costarc/MSX_FPGA_Hat/Hardware Interface/MSX_FPGA_Hat.png

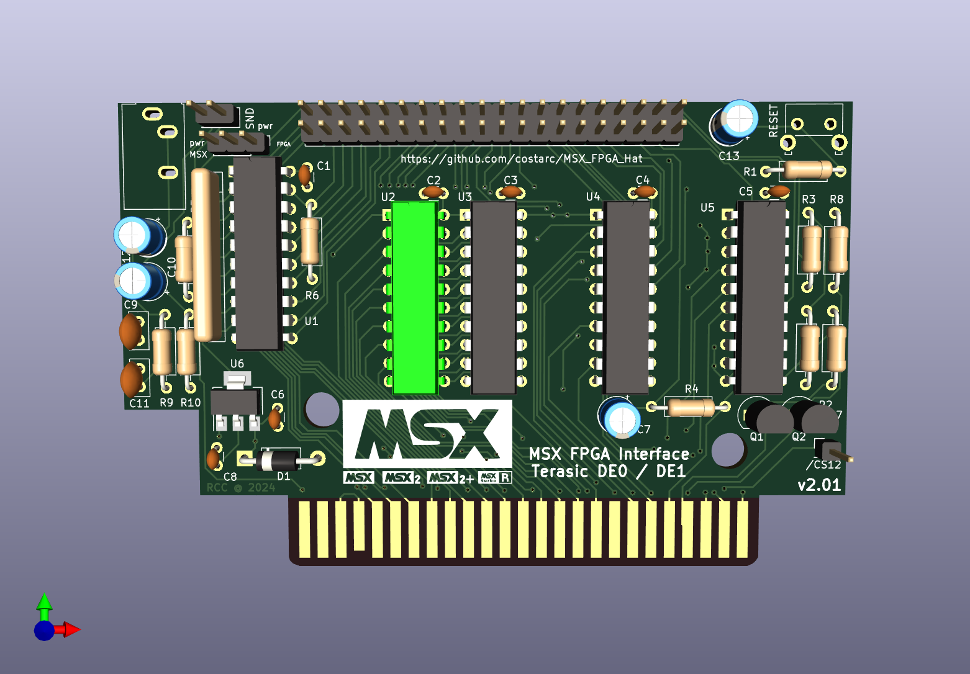
Hardware Interface/MSX_FPGA_Hat.png
