costarc/MSX_FPGA_Hat/Hardware Interface/MSX_FPGA_Hat_b.png

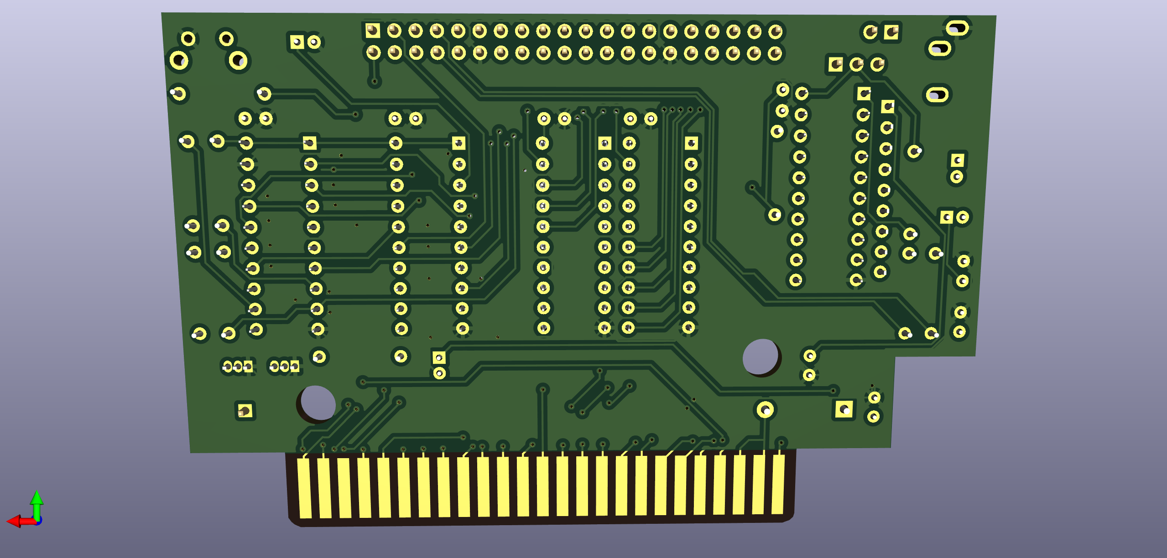
Hardware Interface/MSX_FPGA_Hat_b.png
