costarc/MSX_FPGA_Hat/Reference Designs/Altera DE0 Project/MegaROM_ASCII16/README.md

Design: MegaROM_Konami8

Function: Implements the ASCII16 mapper - 16KB Banks

Features: 
 1. ROMs read from the external Flash ram board
 2. Switch roms using the SW switches

Quick Start Guide
-----------------

1. Connect everything and turn on the DE board
2. Program the DE board with the .sof file
3. Move SW9 to UP position to enable the cartridge core
4. Select the game using SW0, SW1 OR SW3 
   SW0 allows to choose between 2 ROMs moving UP or Down
   SW1 and SW3 select 1 game each when in UP position
