costarc/MSX_FPGA_Hat/Hardware Interface/DE0_Addon_Board/DE0_Addon_Board.png

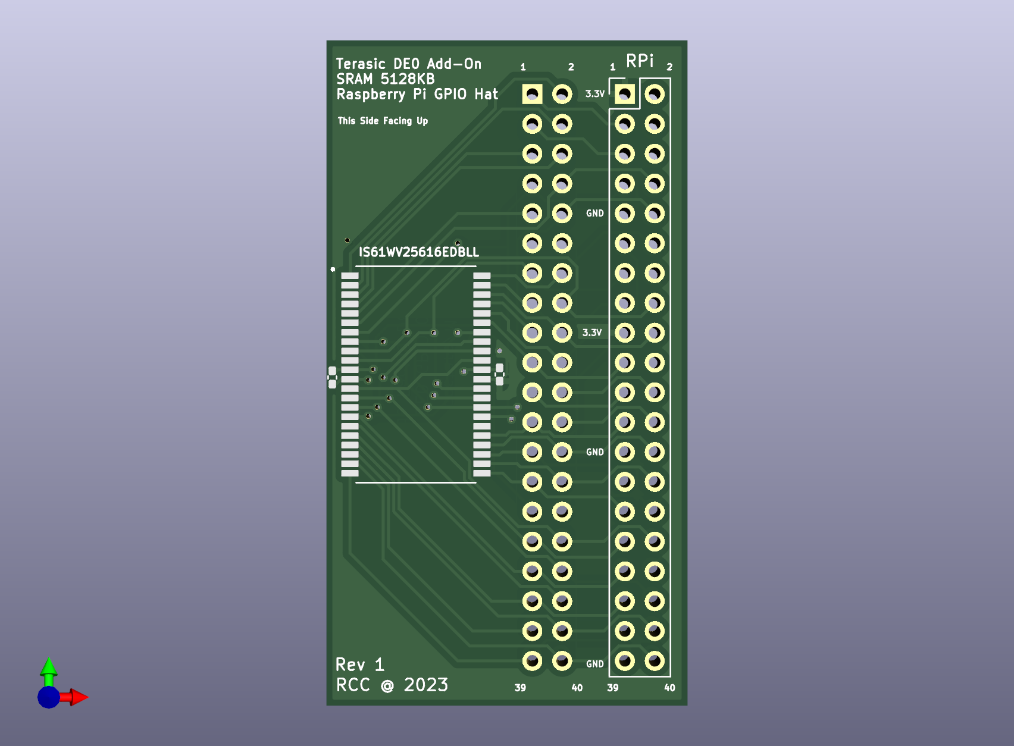
Hardware Interface/DE0_Addon_Board/DE0_Addon_Board.png
