costarc/MSX_FPGA_Hat/Hardware Interface/DE0_Addon_Board/Pin Mapping.png

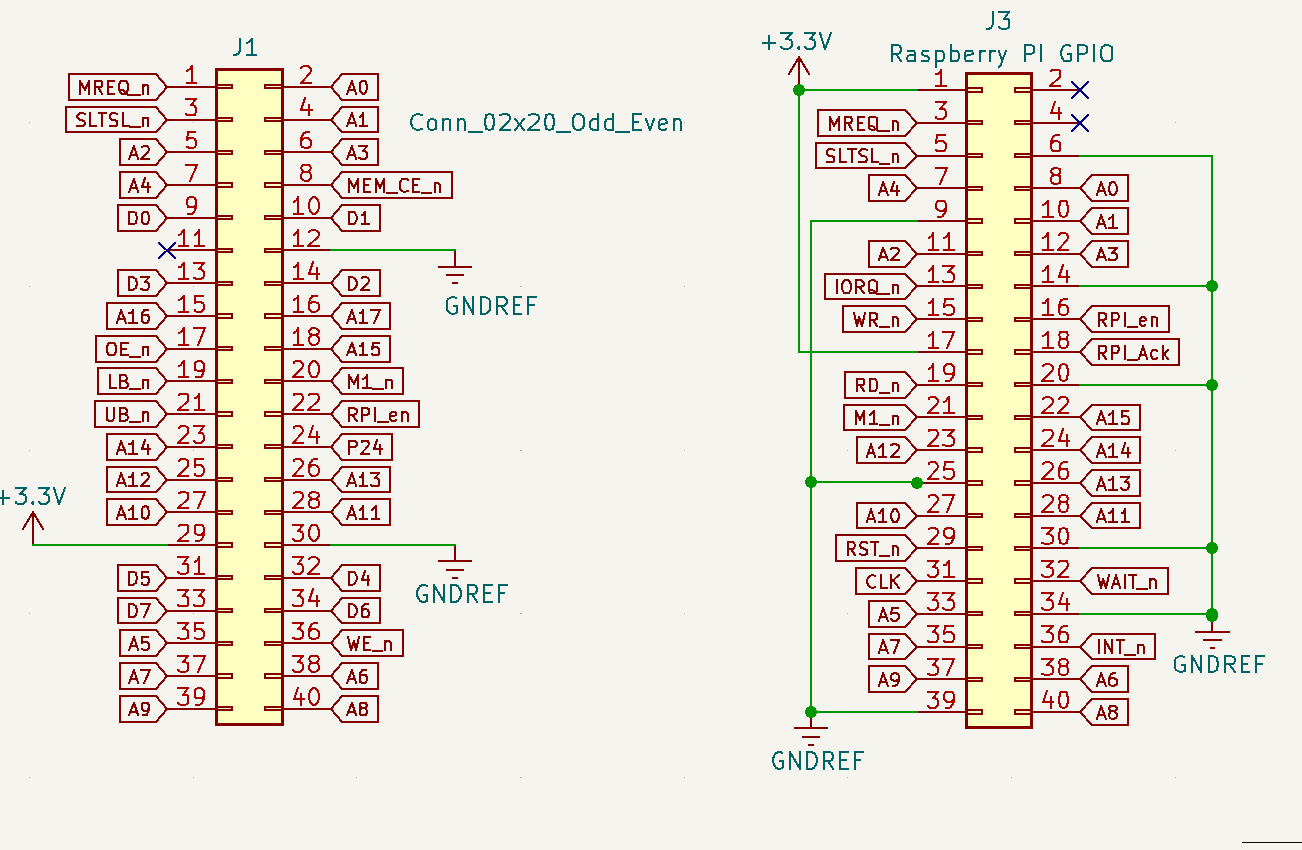
Hardware Interface/DE0_Addon_Board/Pin Mapping.png
