costarc/MSX_FPGA_Hat/Hardware Interface/v1.6/MSX_FPGA_Hat.png

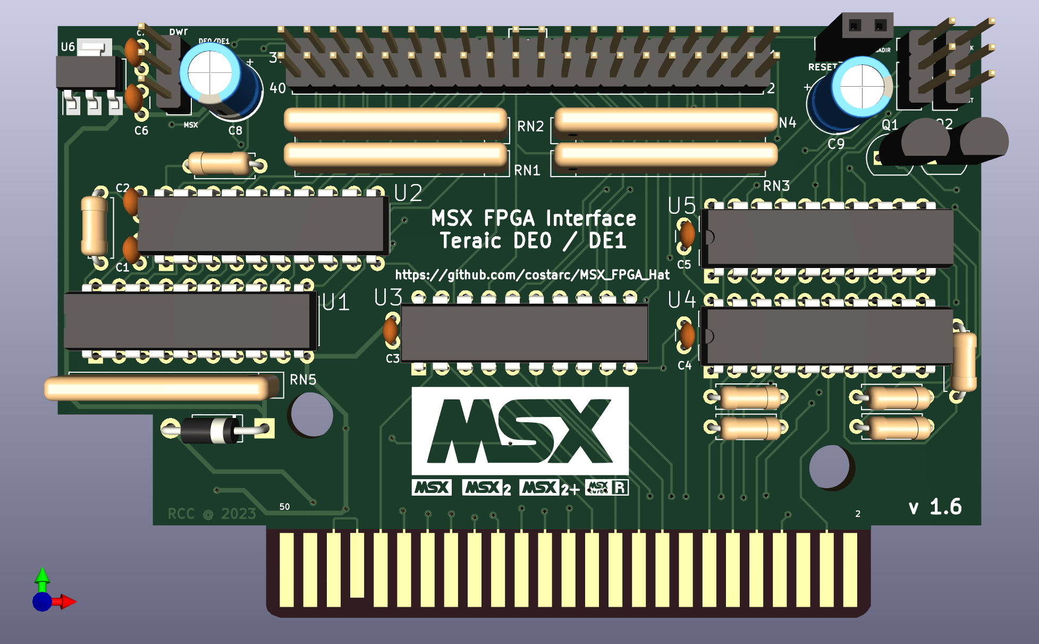
Hardware Interface/v1.6/MSX_FPGA_Hat.png
