costarc/MSX_FPGA_Hat/Hardware Interface/v1.6/MSX_FPGA_Hat.pdf

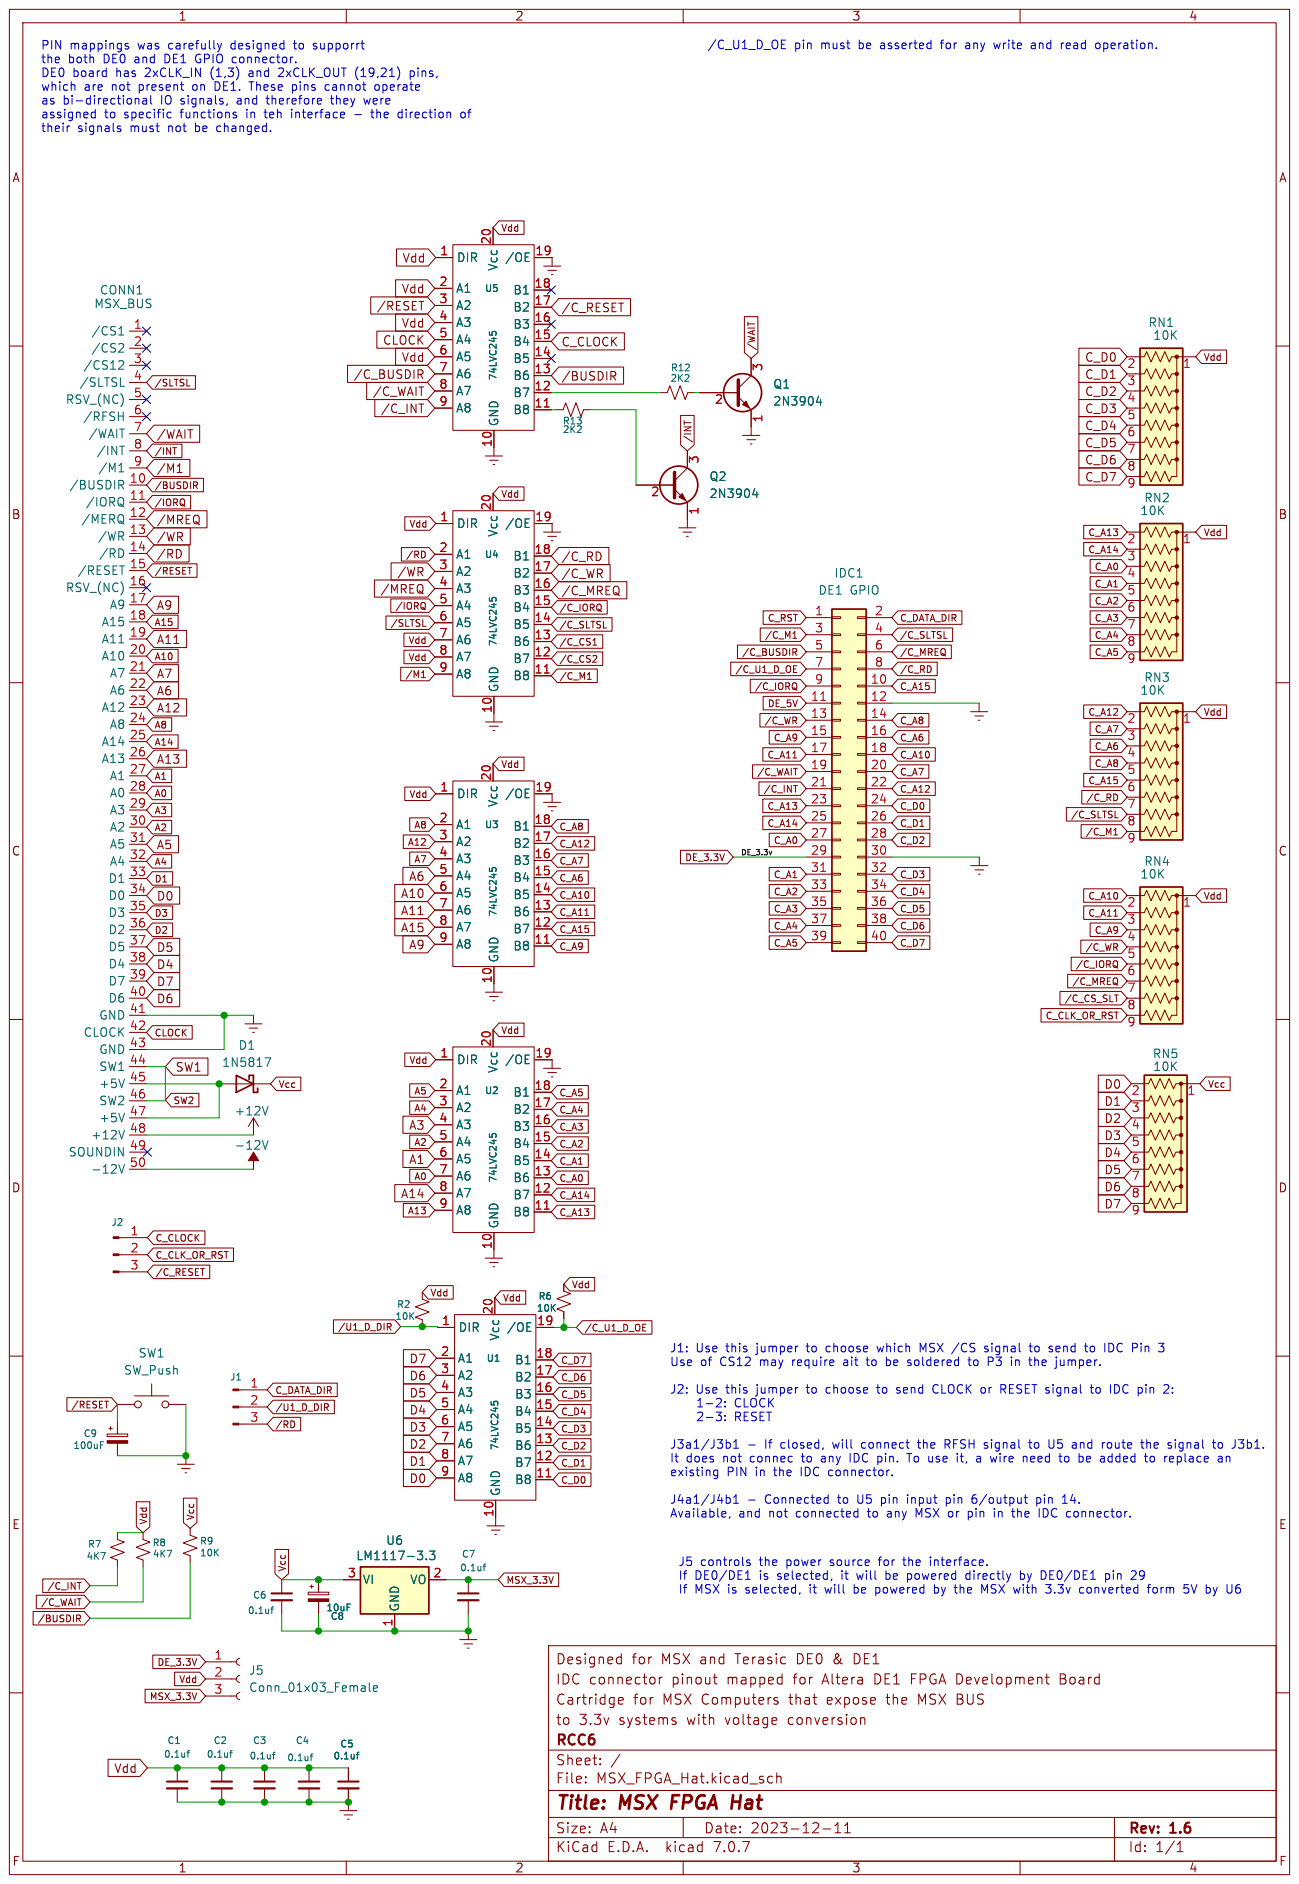
[picture p6: page 1]

/C_U1_D_OE pin must be asserted for any write and read operation.

their signals must not be changed.

It does not connec to any IDC pin. To use it, a wire need to be added to replace an
