costarc/MSX_FPGA_Hat/Hardware Interface/DE0_Addon_Board/DE0_Addon_Board.pdf

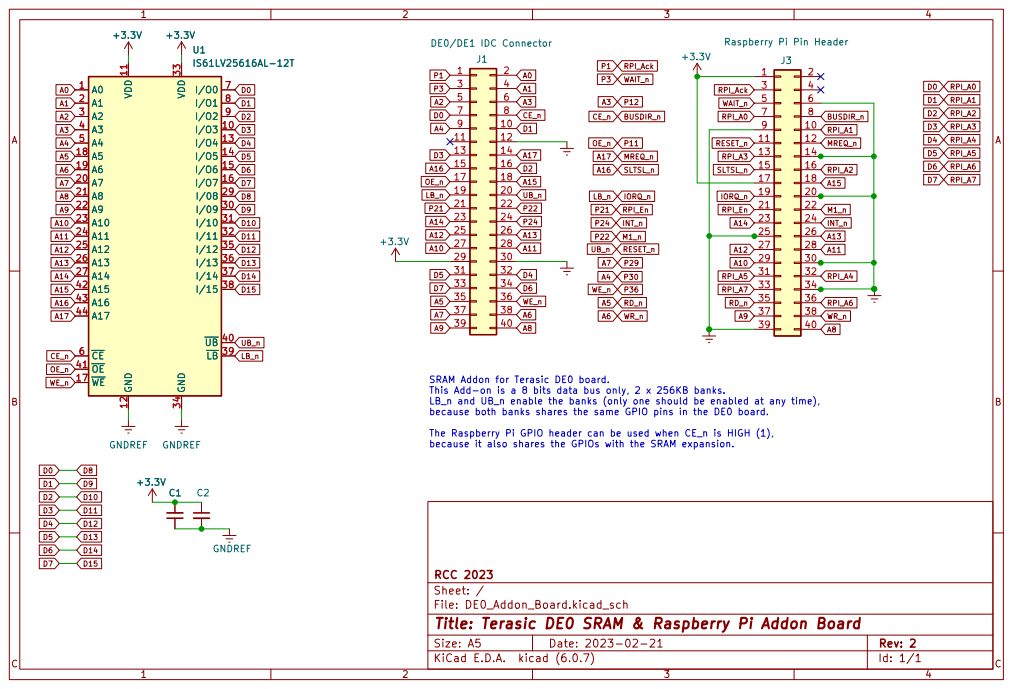
[picture p7: page 1]

+3.3V

J3 Raspberry Pi Pin Header GNDREF

LB_n and UB_n enable the banks (only one should be enabled at any time),
because both banks shares the same GPIO pins in the DE0 board.

The Raspberry Pi GPIO header can be used when CE_n is HIGH (1),

Id: 1/1 Title: Terasic DE0 SRAM & Raspberry Pi Addon Board
