costarc/MSX_FPGA_Hat/Reference Designs/Altera DE0 Project/SDMapper/SDPINOUT.pdf

## DAT2 N/C

## DAT3 CS#

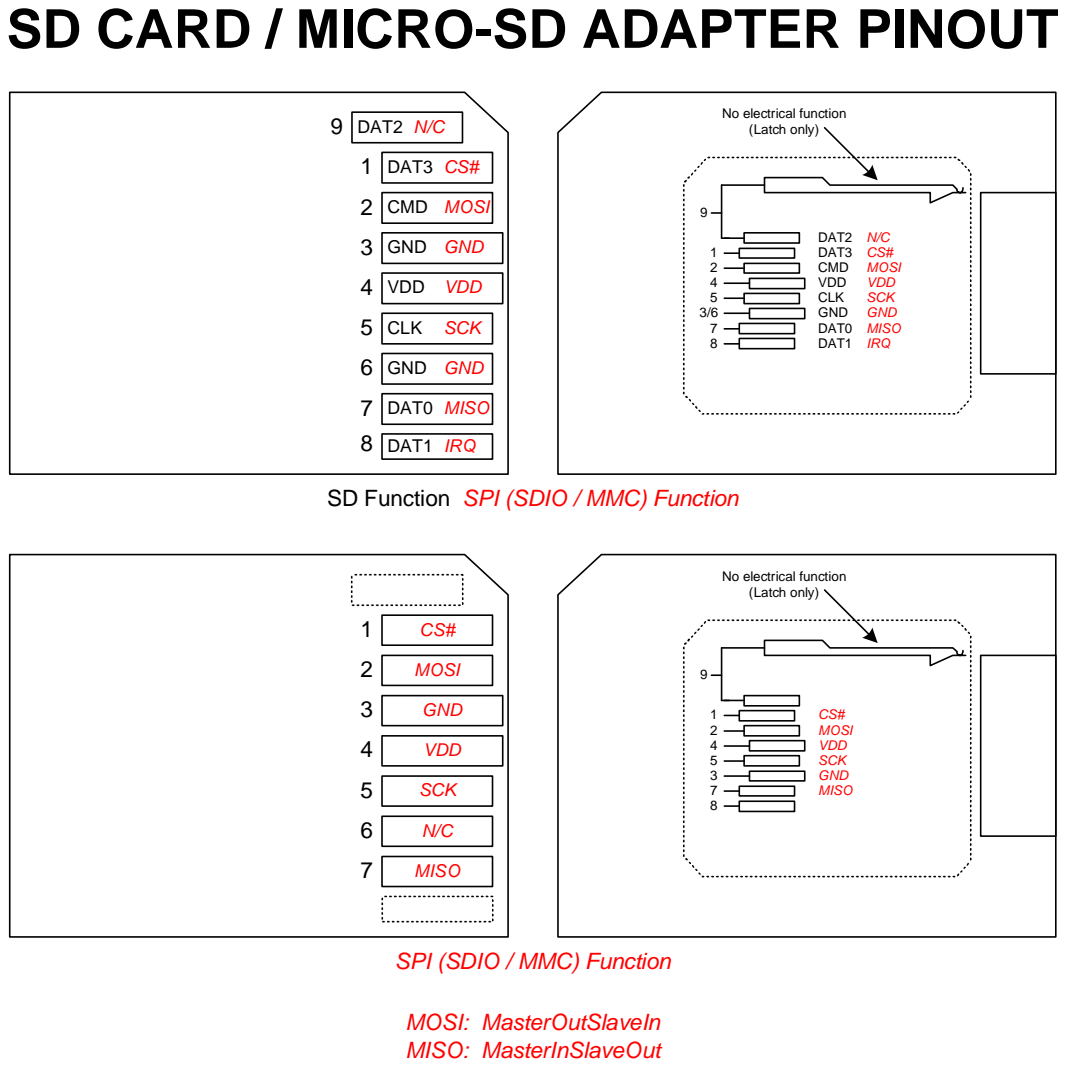
[picture p8: page 1]
CMD MOSI; GND GND; VDD VDD; CLK SCK; DAT0 MISO; DAT1 IRQ; DAT2 N/C DAT3 CS# CMD MOSI; VDD; CLK; SCK; GND; DAT0 MISO DAT1 IRQ; MOSI; MISO; CS# MOSI VDD SCK GND MISO; MOSI: MasterOutSlaveIn MISO: MasterInSlaveOut

SD CARD / MICRO-SD ADAPTER PINOUT

No electrical function
(Latch only)

SD Function SPI (SDIO / MMC) Function

SPI (SDIO / MMC) Function
