costarc/MSX_FPGA_Hat/Hardware Interface/Previous Versions/v1.0/MSX_IDC_Interface.pdf

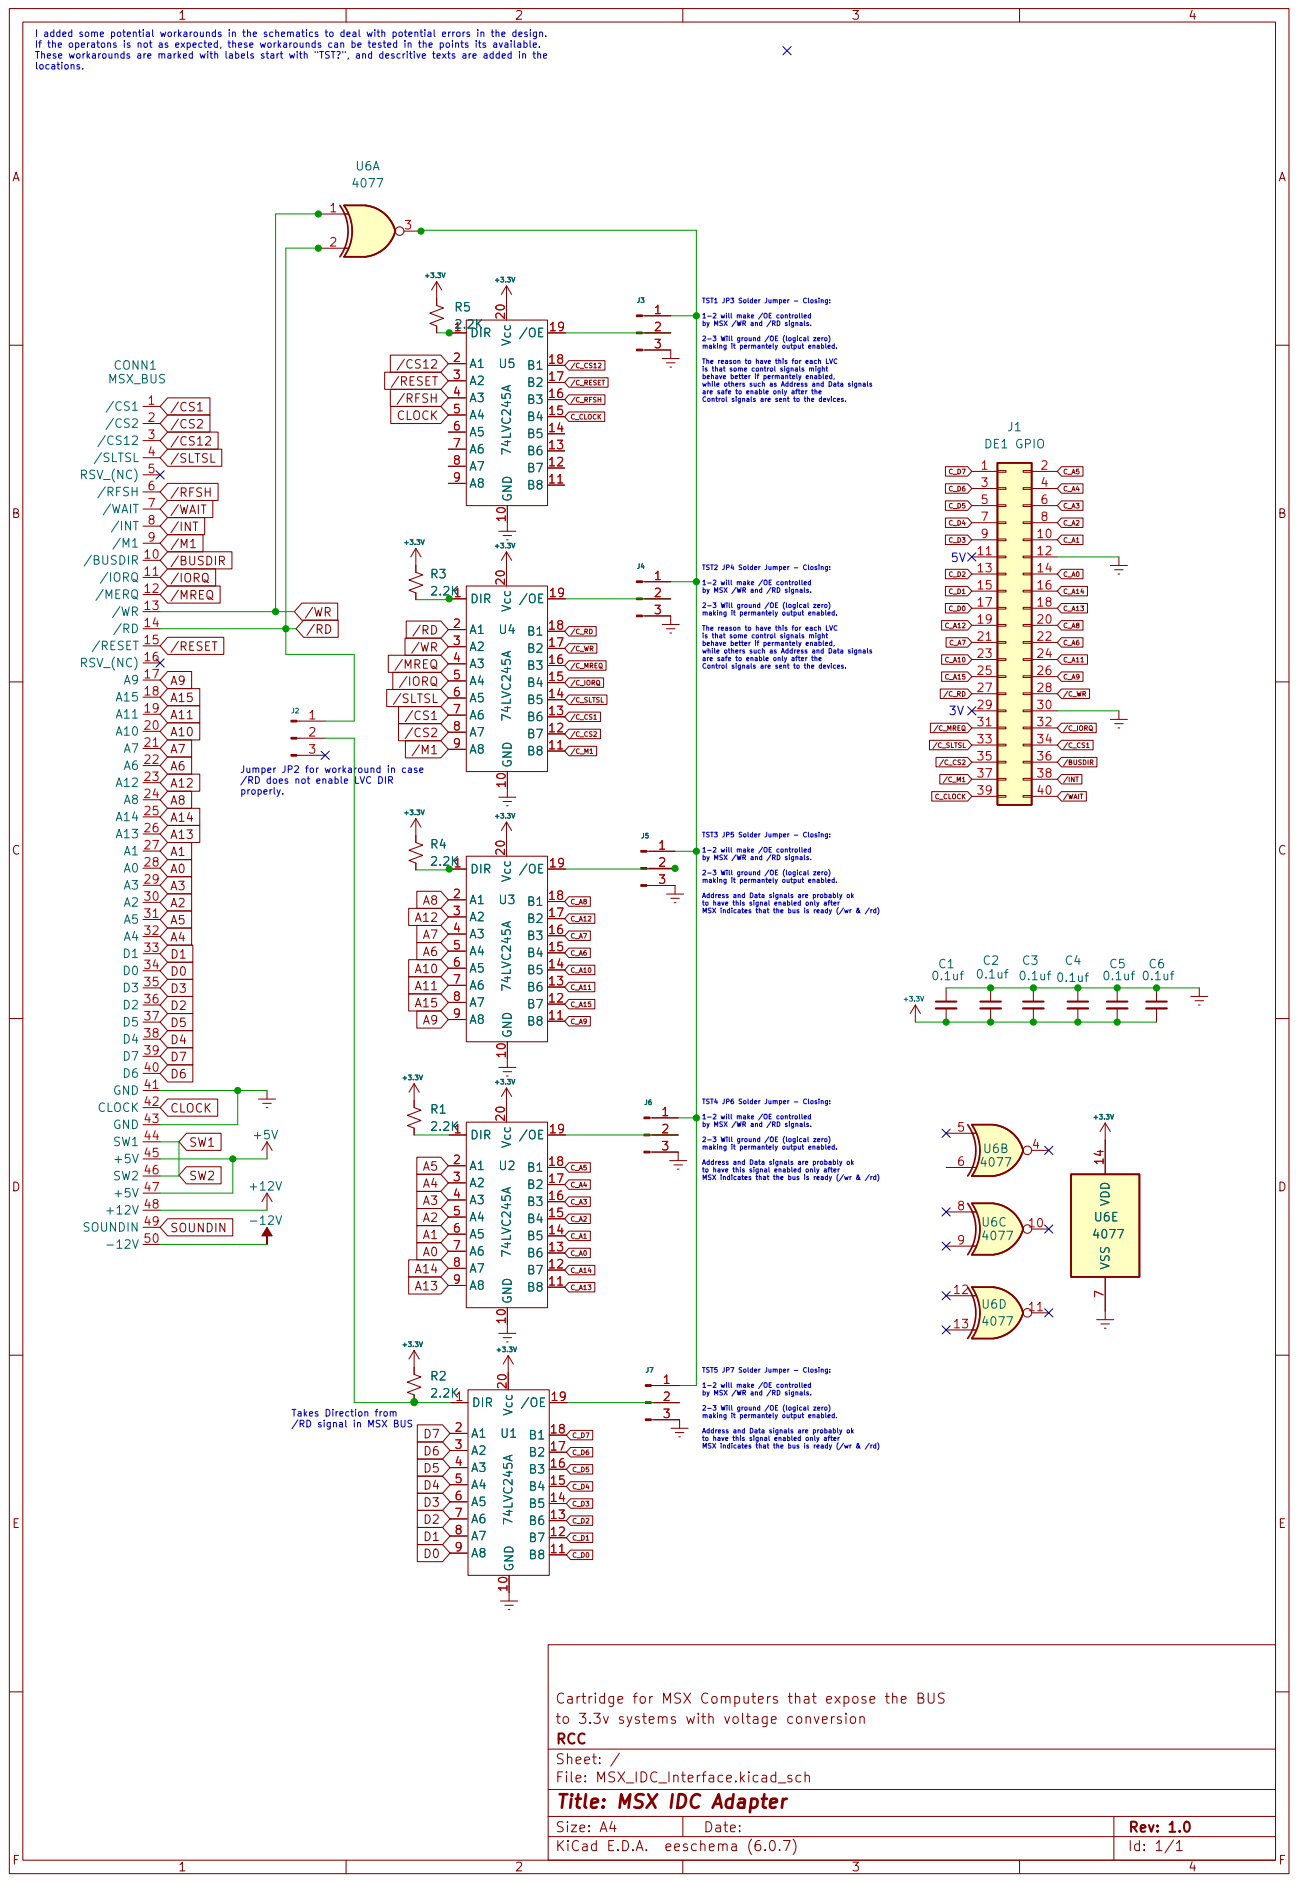
[picture p10: page 1]

I added some potential workarounds in the schematics to deal with potential errors in the design.
If the operatons is not as expected, these workarounds can be tested in the points its available. These workarounds are marked with labels start with "TST?", and descritive texts are added in the

TST1 JP3 Solder Jumper - Closing: 1-2 will make /OE controlled

by MSX /WR and /RD signals. 2-3 Will ground /OE (logical zero) making it permantely output enabled. The reason to have this for each LVC

is that some control signals might behave better if permantely enabled, while others such as Address and Data signals are safe to enable only after the Control signals are sent to the devices.

TST2 JP4 Solder Jumper - Closing: 1-2 will make /OE controlled

Jumper JP2 for workaround in case
/RD does not enable LVC DIR
properly.

by MSX /WR and /RD signals. 2-3 Will ground /OE (logical zero) making it permantely output enabled. Address and Data signals are probably ok

to have this signal enabled only after MSX indicates that the bus is ready (/wr & /rd)

to have this signal enabled only after MSX indicates that the bus is ready (/wr & /rd) Takes Direction from
/RD signal in MSX BUS

Cartridge for MSX Computers that expose the BUS
to 3.3v systems with voltage conversion
File: MSX_IDC_Interface.kicad_sch Sheet: / RCC

Id: 1/1 Title: MSX IDC Adapter
