costarc/MSX_FPGA_Hat/Hardware Interface/v1.2/DE0_Addon_Board/DE0_Addon_Board.pdf

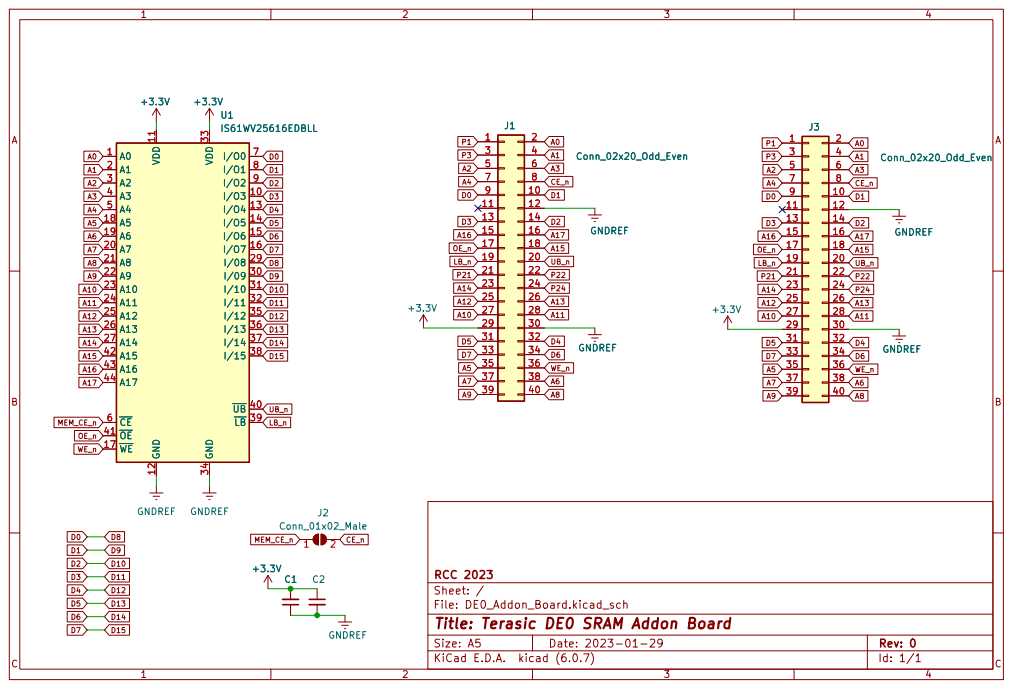
[picture p12: page 1]

Id: 1/1 Title: Terasic DE0 SRAM Addon Board
