costarc/MSX_FPGA_Hat/Hardware Interface/Previous Versions/v1.0/MSX_IDC_ADAPTER.pdf

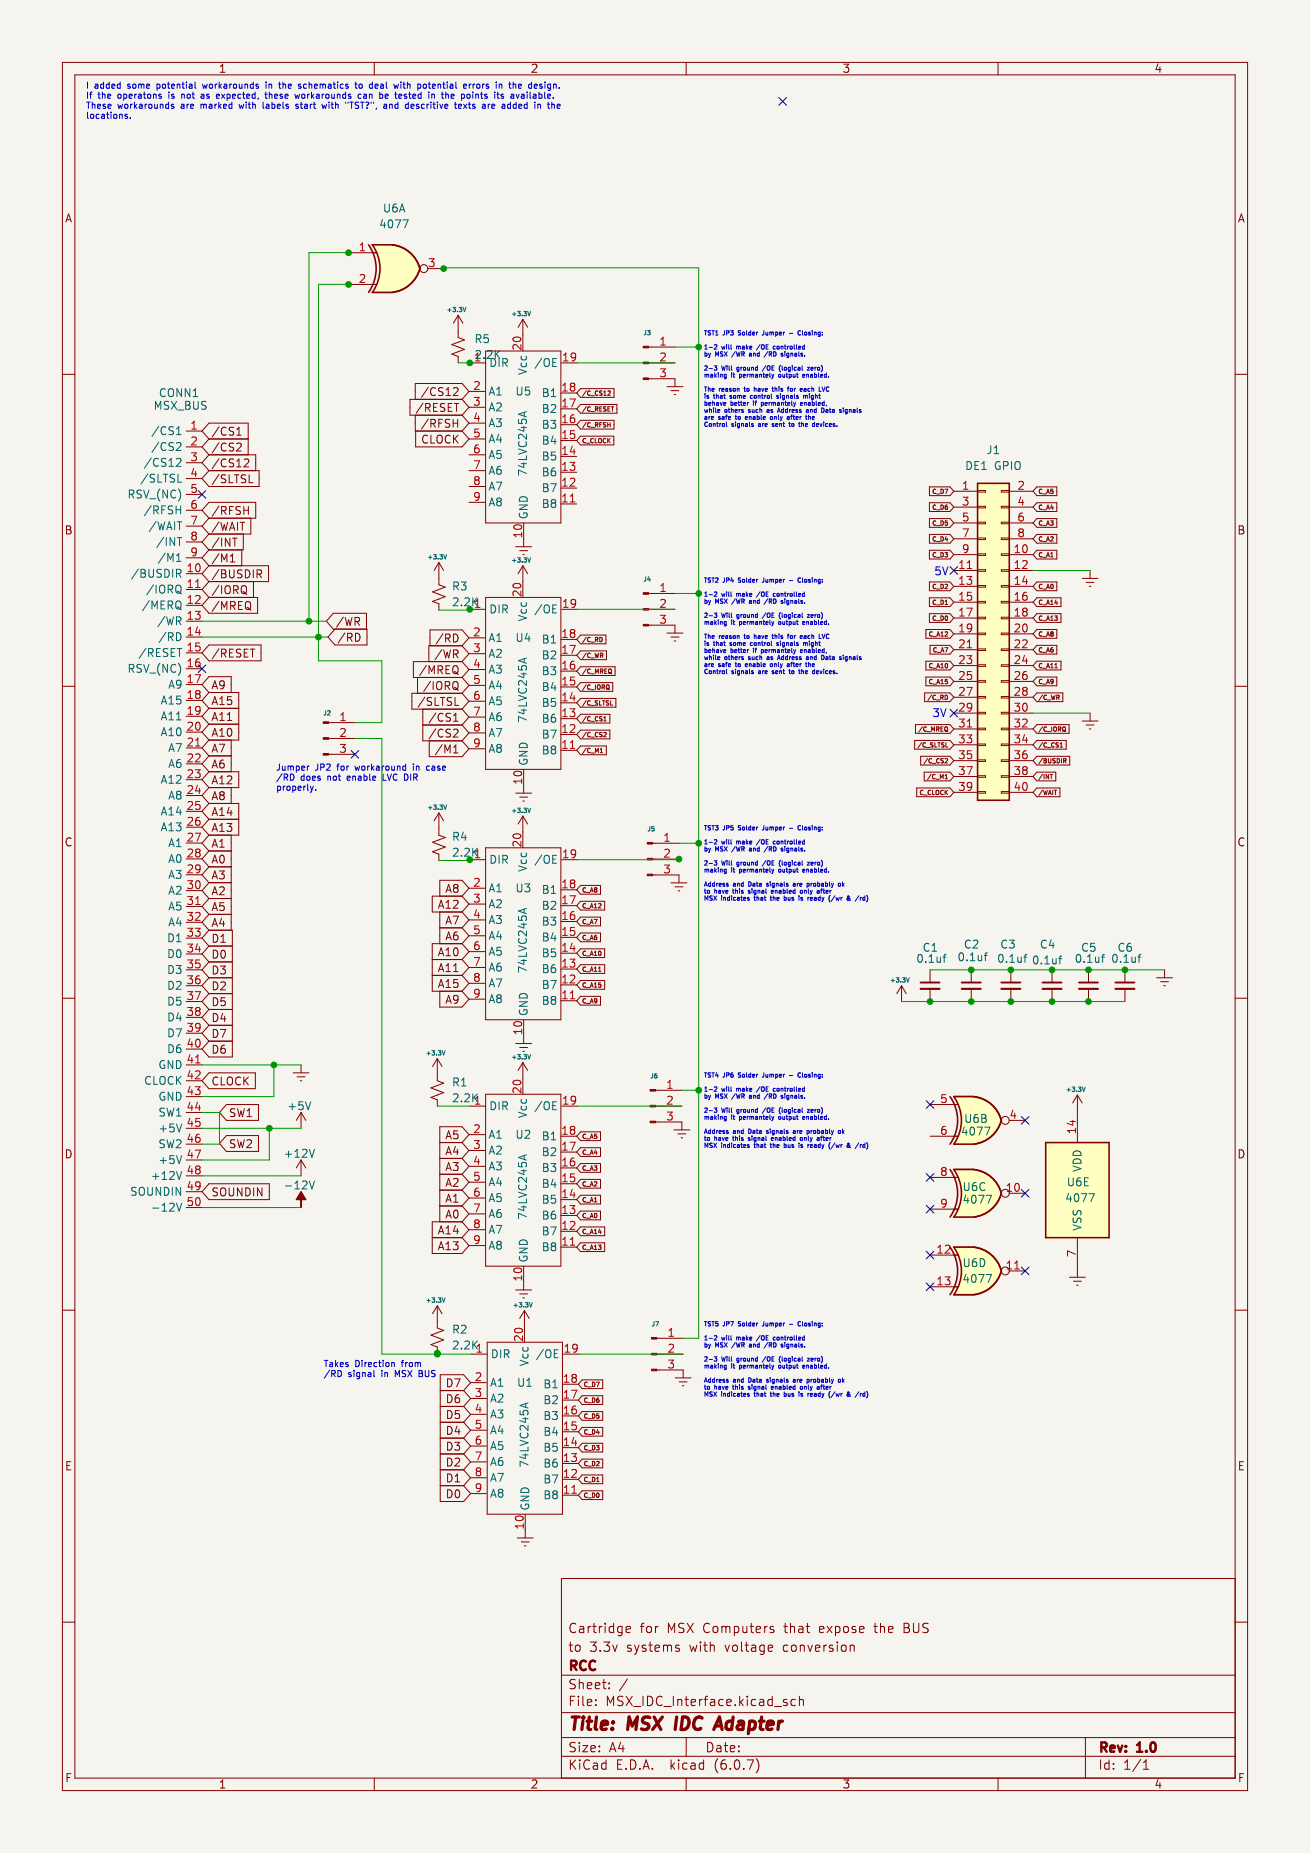
[picture p13: page 1]
