costarc/MSX_FPGA_Hat/Hardware Interface/Previous Versions/v1.1/MSX_FPGA_Hat.kicad_pcb

## KiCad design Hardware Interface/Previous Versions/v1.1/MSX_FPGA_Hat.kicad_pcb (2023-01-31, an earlier design)

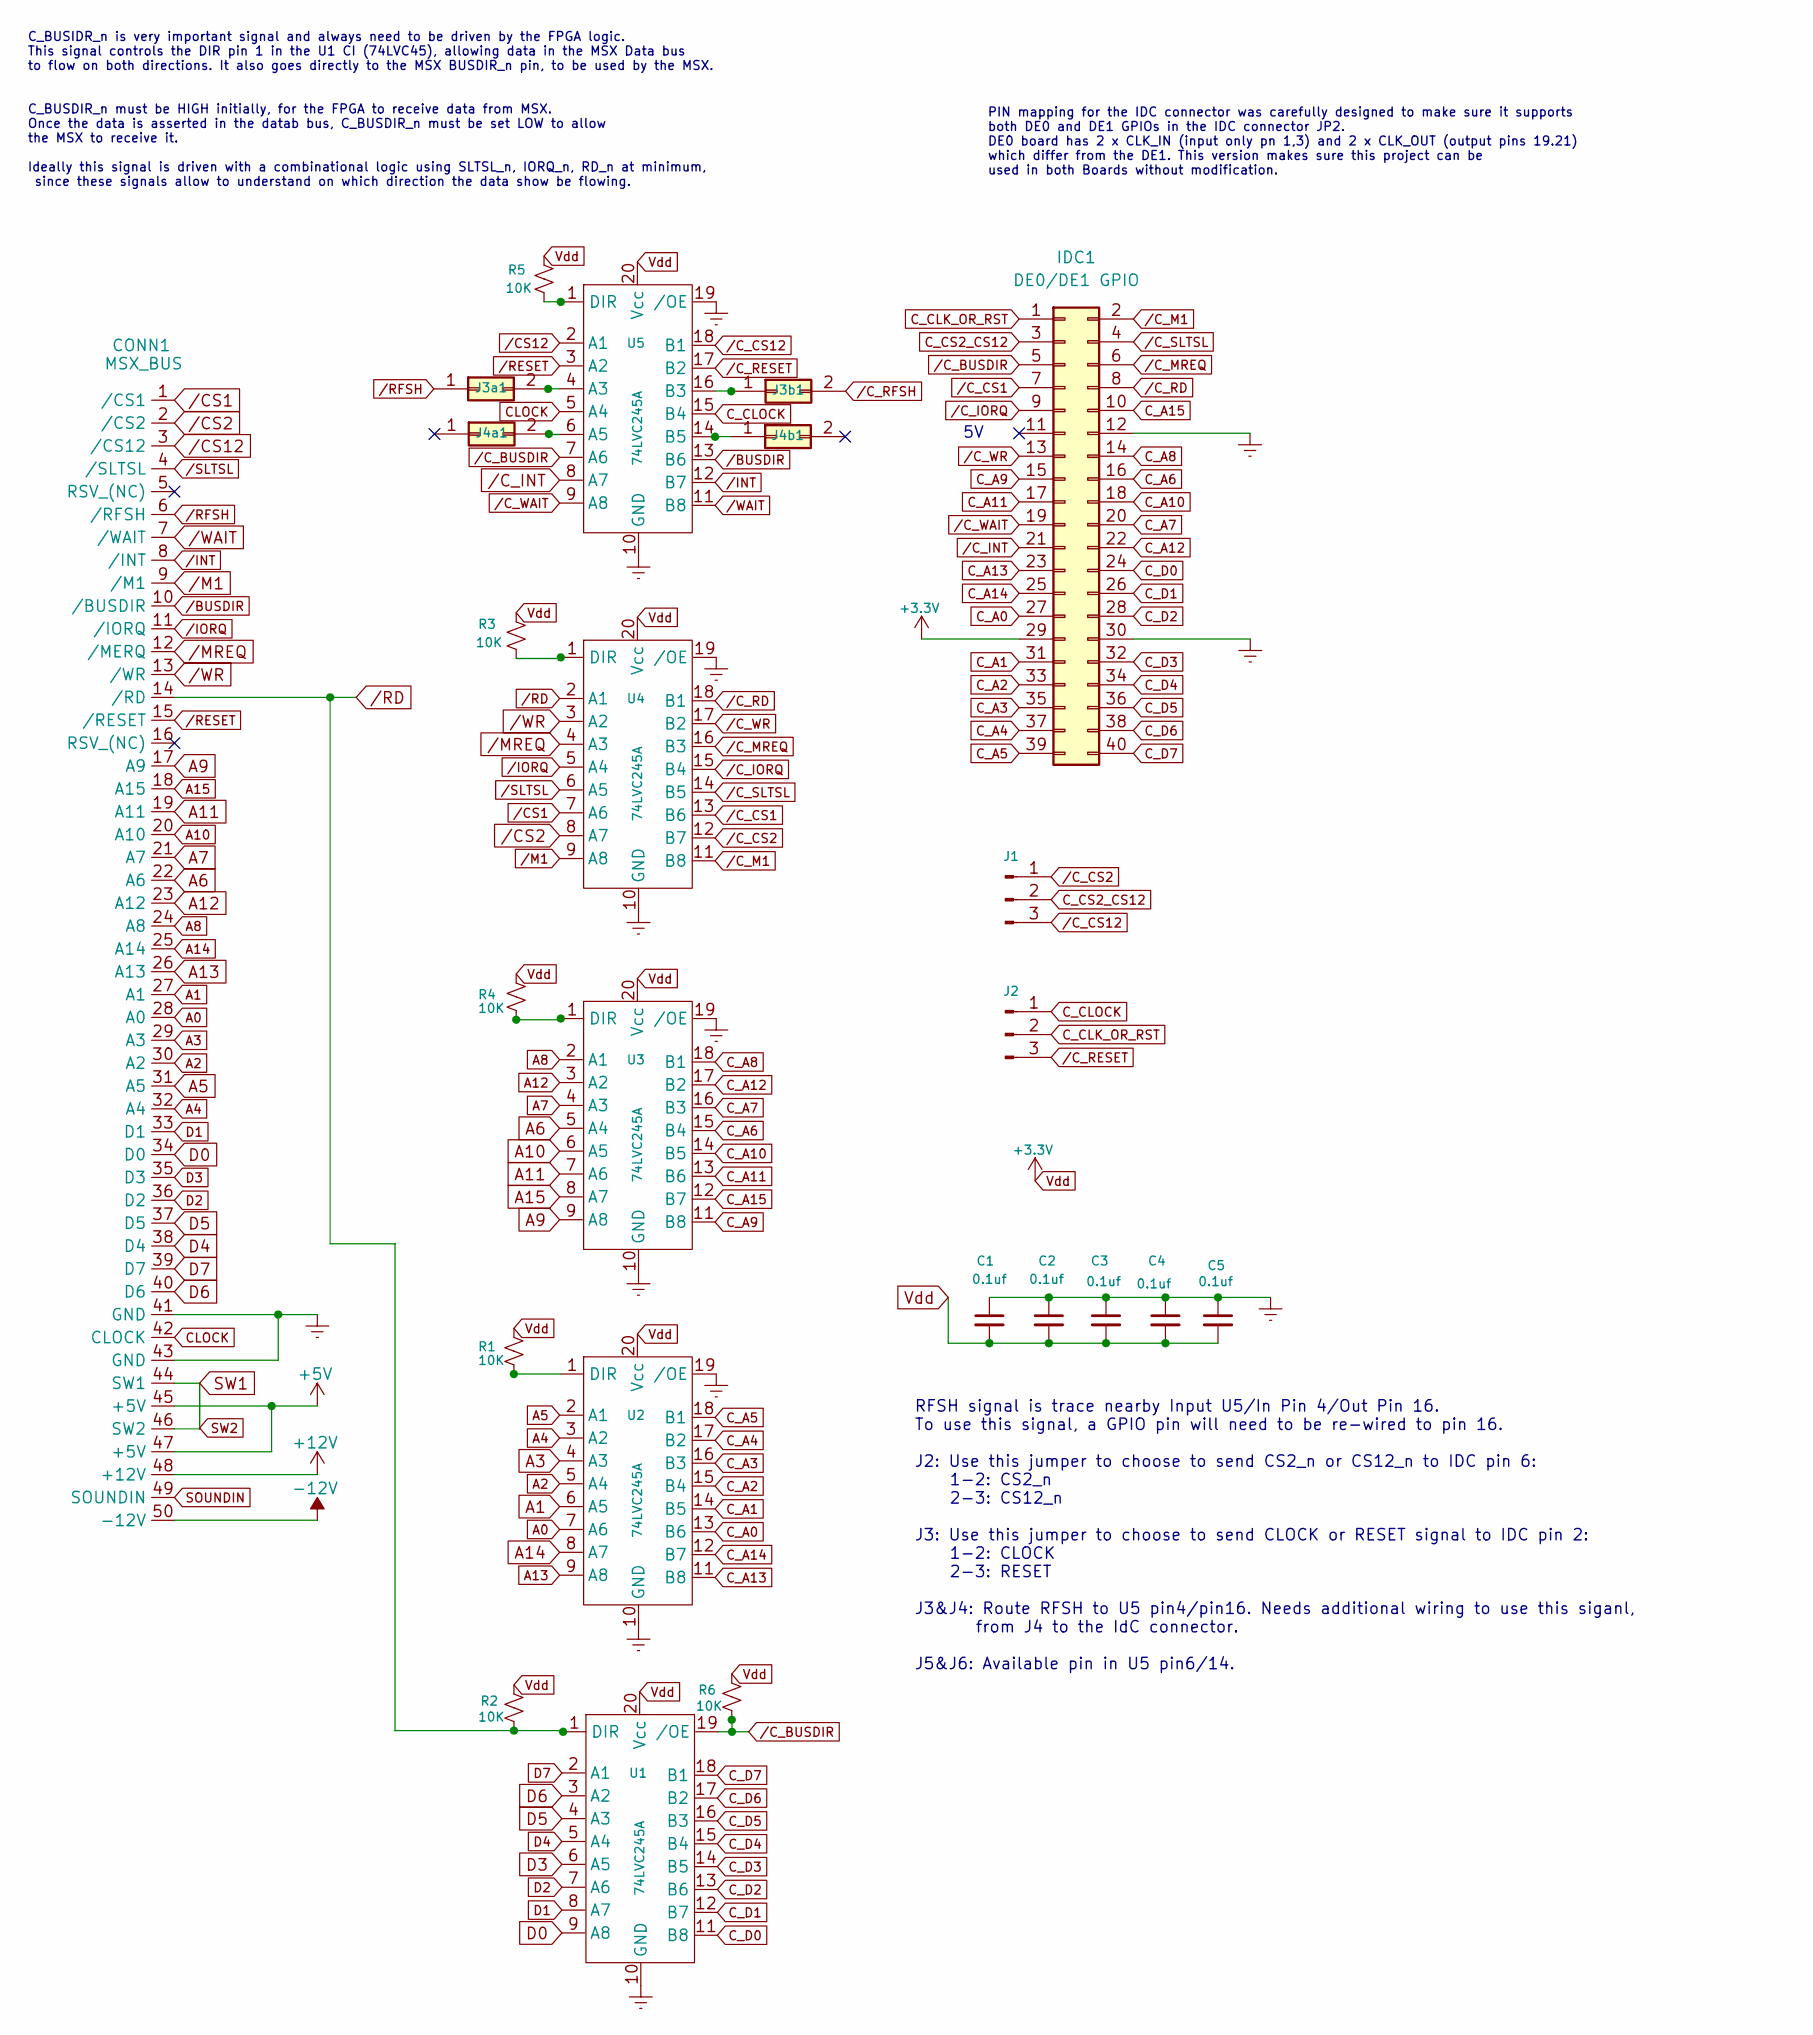
[picture p16: schematic MSX_FPGA_Hat.kicad_sch, MSX FPGA Hat]

Parts:
C1, C2, C3, C4, C5: 0.1uf; C_Disc_D3.0mm_W1.6mm_P2.50mm
CONN1: MSX_BUS; MSX_CART
IDC1: DE0/DE1 GPIO; PinHeader_2x20_P2.54mm_Vertical
J1: J1; PinHeader_1x03_P2.54mm_Vertical
J2: J2; PinHeader_1x03_P2.54mm_Vertical
J3a1: J3a; PinHeader_1x02_P2.54mm_Vertical
J3b1: J3b; PinHeader_1x02_P2.54mm_Vertical
J4a1: J4a; PinHeader_1x02_P2.54mm_Vertical
J4b1: J4b; PinHeader_1x02_P2.54mm_Vertical
R1, R2, R3, R4, R5, R6: 10K; R_Axial_DIN0207_L6.3mm_D2.5mm_P7.62mm_Horizontal
U1, U2, U3, U4, U5: 74LVC245A; DIP-20_W7.62mm

Connections:
+5V: CONN1.45 (+5V), CONN1.47 (+5V)
+12V: CONN1.48 (+12V)
-12V: CONN1.50 (-12V)
A0: CONN1.28 (A0), U2.7 (A6)
A1: CONN1.27 (A1), U2.6 (A5)
A2: CONN1.30 (A2), U2.5 (A4)
A3: CONN1.29 (A3), U2.4 (A3)
A4: CONN1.32 (A4), U2.3 (A2)
A5: CONN1.31 (A5), U2.2 (A1)
A6: CONN1.22 (A6), U3.5 (A4)
A7: CONN1.21 (A7), U3.4 (A3)
A8: CONN1.24 (A8), U3.2 (A1)
A9: CONN1.17 (A9), U3.9 (A8)
A10: CONN1.20 (A10), U3.6 (A5)
A11: CONN1.19 (A11), U3.7 (A6)
A12: CONN1.23 (A12), U3.3 (A2)
A13: CONN1.26 (A13), U2.9 (A8)
A14: CONN1.25 (A14), U2.8 (A7)
A15: CONN1.18 (A15), U3.8 (A7)
CLOCK: CONN1.42 (CLOCK), U5.5 (A4)
C_A0: IDC1.27, U2.13 (B6)
C_A1: IDC1.31, U2.14 (B5)
C_A2: IDC1.33, U2.15 (B4)
C_A3: IDC1.35, U2.16 (B3)
C_A4: IDC1.37, U2.17 (B2)
C_A5: IDC1.39, U2.18 (B1)
C_A6: IDC1.16, U3.15 (B4)
C_A7: IDC1.20, U3.16 (B3)
C_A8: IDC1.14, U3.18 (B1)
C_A9: IDC1.15, U3.11 (B8)
C_A10: IDC1.18, U3.14 (B5)
C_A11: IDC1.17, U3.13 (B6)
C_A12: IDC1.22, U3.17 (B2)
C_A13: IDC1.23, U2.11 (B8)
C_A14: IDC1.25, U2.12 (B7)
C_A15: IDC1.10, U3.12 (B7)
C_CLK_OR_RST: IDC1.1, J2.2
C_CLOCK: J2.1, U5.15 (B4)
C_CS2_CS12: IDC1.3, J1.2
C_D0: IDC1.24, U1.11 (B8)
C_D1: IDC1.26, U1.12 (B7)
C_D2: IDC1.28, U1.13 (B6)
C_D3: IDC1.32, U1.14 (B5)
C_D4: IDC1.34, U1.15 (B4)
C_D5: IDC1.36, U1.16 (B3)
C_D6: IDC1.38, U1.17 (B2)
C_D7: IDC1.40, U1.18 (B1)
D0: CONN1.34 (D0), U1.9 (A8)
D1: CONN1.33 (D1), U1.8 (A7)
D2: CONN1.36 (D2), U1.7 (A6)
D3: CONN1.35 (D3), U1.6 (A5)
D4: CONN1.38 (D4), U1.5 (A4)
D5: CONN1.37 (D5), U1.4 (A3)
D6: CONN1.40 (D6), U1.3 (A2)
D7: CONN1.39 (D7), U1.2 (A1)
GNDREF: C1.1, C2.1, C3.1, C4.1, C5.1, CONN1.41 (GND), CONN1.43 (GND), IDC1.12, IDC1.30, U1.10 (GND), U2.10 (GND), U2.19 (/OE), U3.10 (GND), U3.19 (/OE), U4.10 (GND), U4.19 (/OE), U5.10 (GND), U5.19 (/OE)
unnamed: J3a1.2, U5.4 (A3)
unnamed: J3b1.1, U5.16 (B3)
unnamed: J4a1.2, U5.6 (A5)
unnamed: J4b1.1, U5.14 (B5)
unnamed: R1.2, U2.1 (DIR)
unnamed: R3.2, U4.1 (DIR)
unnamed: R4.2, U3.1 (DIR)
unnamed: R5.2, U5.1 (DIR)
SOUNDIN: CONN1.49 (SOUNDIN)
SW1: CONN1.44 (SW1), CONN1.46 (SW2)
Vdd: C1.2, C2.2, C3.2, C4.2, C5.2, IDC1.29, R1.1, R2.1, R3.1, R4.1, R5.1, R6.1, U1.20 (Vcc), U2.20 (Vcc), U3.20 (Vcc), U4.20 (Vcc), U5.20 (Vcc)
/BUSDIR: CONN1.10 (/BUSDIR), U5.13 (B6)
/CS1: CONN1.1 (/CS1), U4.7 (A6)
/CS2: CONN1.2 (/CS2), U4.8 (A7)
/CS12: CONN1.3 (/CS12), U5.2 (A1)
/C_BUSDIR: IDC1.5, R6.2, U1.19 (/OE), U5.7 (A6)
/C_CS1: IDC1.7, U4.13 (B6)
/C_CS2: J1.1, U4.12 (B7)
/C_CS12: J1.3, U5.18 (B1)
/C_INT: IDC1.21, U5.8 (A7)
/C_IORQ: IDC1.9, U4.15 (B4)
/C_M1: IDC1.2, U4.11 (B8)
/C_MREQ: IDC1.6, U4.16 (B3)
/C_RD: IDC1.8, U4.18 (B1)
/C_RESET: J2.3, U5.17 (B2)
/C_RFSH: J3b1.2
/C_SLTSL: IDC1.4, U4.14 (B5)
/C_WAIT: IDC1.19, U5.9 (A8)
/C_WR: IDC1.13, U4.17 (B2)
/INT: CONN1.8 (/INT), U5.12 (B7)
/IORQ: CONN1.11 (/IORQ), U4.5 (A4)
/M1: CONN1.9 (/M1), U4.9 (A8)
/MREQ: CONN1.12 (/MERQ), U4.4 (A3)
/RD: CONN1.14 (/RD), R2.2, U1.1 (DIR), U4.2 (A1)
/RESET: CONN1.15 (/RESET), U5.3 (A2)
/RFSH: CONN1.6 (/RFSH), J3a1.1
/SLTSL: CONN1.4 (/SLTSL), U4.6 (A5)
/WAIT: CONN1.7 (/WAIT), U5.11 (B8)
/WR: CONN1.13 (/WR), U4.3 (A2)

Notes on the sheet:
PIN mapping for the IDC connector was carefully designed to make sure it supports both DE0 and DE1 GPIOs in the IDC connector JP2. DE0 board has 2 x CLK_IN (input only pn 1,3) and 2 x CLK_OUT (output pins 19.21) which differ from the DE1. This version makes sure this project can be used in both Boa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
RFSH signal is trace nearby Input U5/In Pin 4/Out Pin 16. To use this signal, a GPIO pin will need to be re-wired to pin 16. J2: Use this jumper to choose to send CS2_n or CS12_n to IDC pin 6: 1-2: CS2_n 2-3: CS12_n J3: Use this jumper to choose to send CLOCK or RESET signal to IDC pin 2: 1-2: CLOC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
C_BUSIDR_n is very important signal and always need to be driven by the FPGA logic. This signal controls the DIR pin 1 in the U1 CI (74LVC45), allowing data in the MSX Data bus to flow on both directions. It also goes directly to the MSX BUSDIR_n pin, to be used by the MSX. C_BUSDIR_n must be HIGH 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

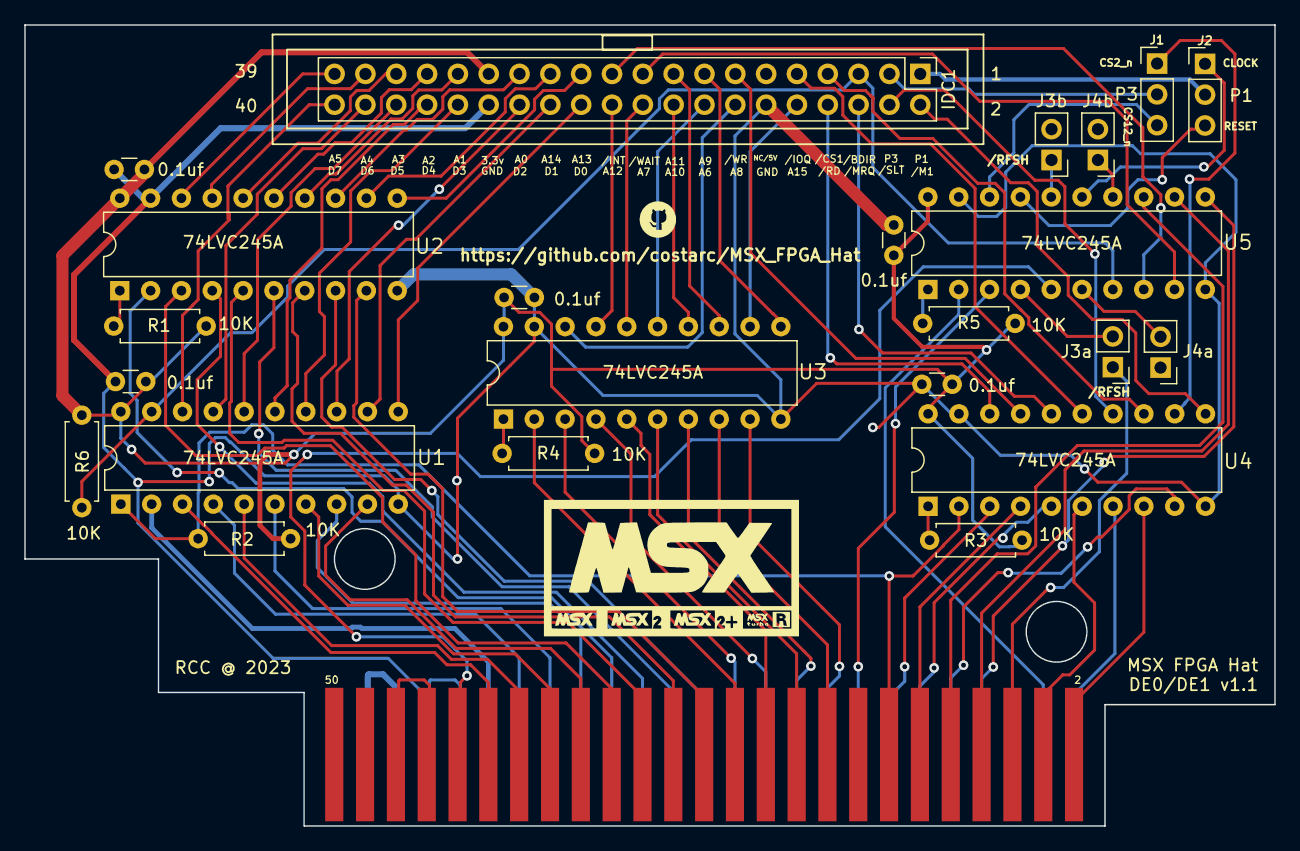
[picture p17: board Hardware Interface/Previous Versions/v1.1/MSX_FPGA_Hat.kicad_pcb from above]

Board: 2 copper layers, 103.0 x 66.0 mm, 24 parts (0 on the bottom side), 91 nets.
