costarc/MSX_FPGA_Hat/Hardware Interface/Previous Versions/v1.6/MSX_FPGA_Hat.kicad_pcb

## KiCad design Hardware Interface/Previous Versions/v1.6/MSX_FPGA_Hat.kicad_pcb (2023-12-11, an earlier design)

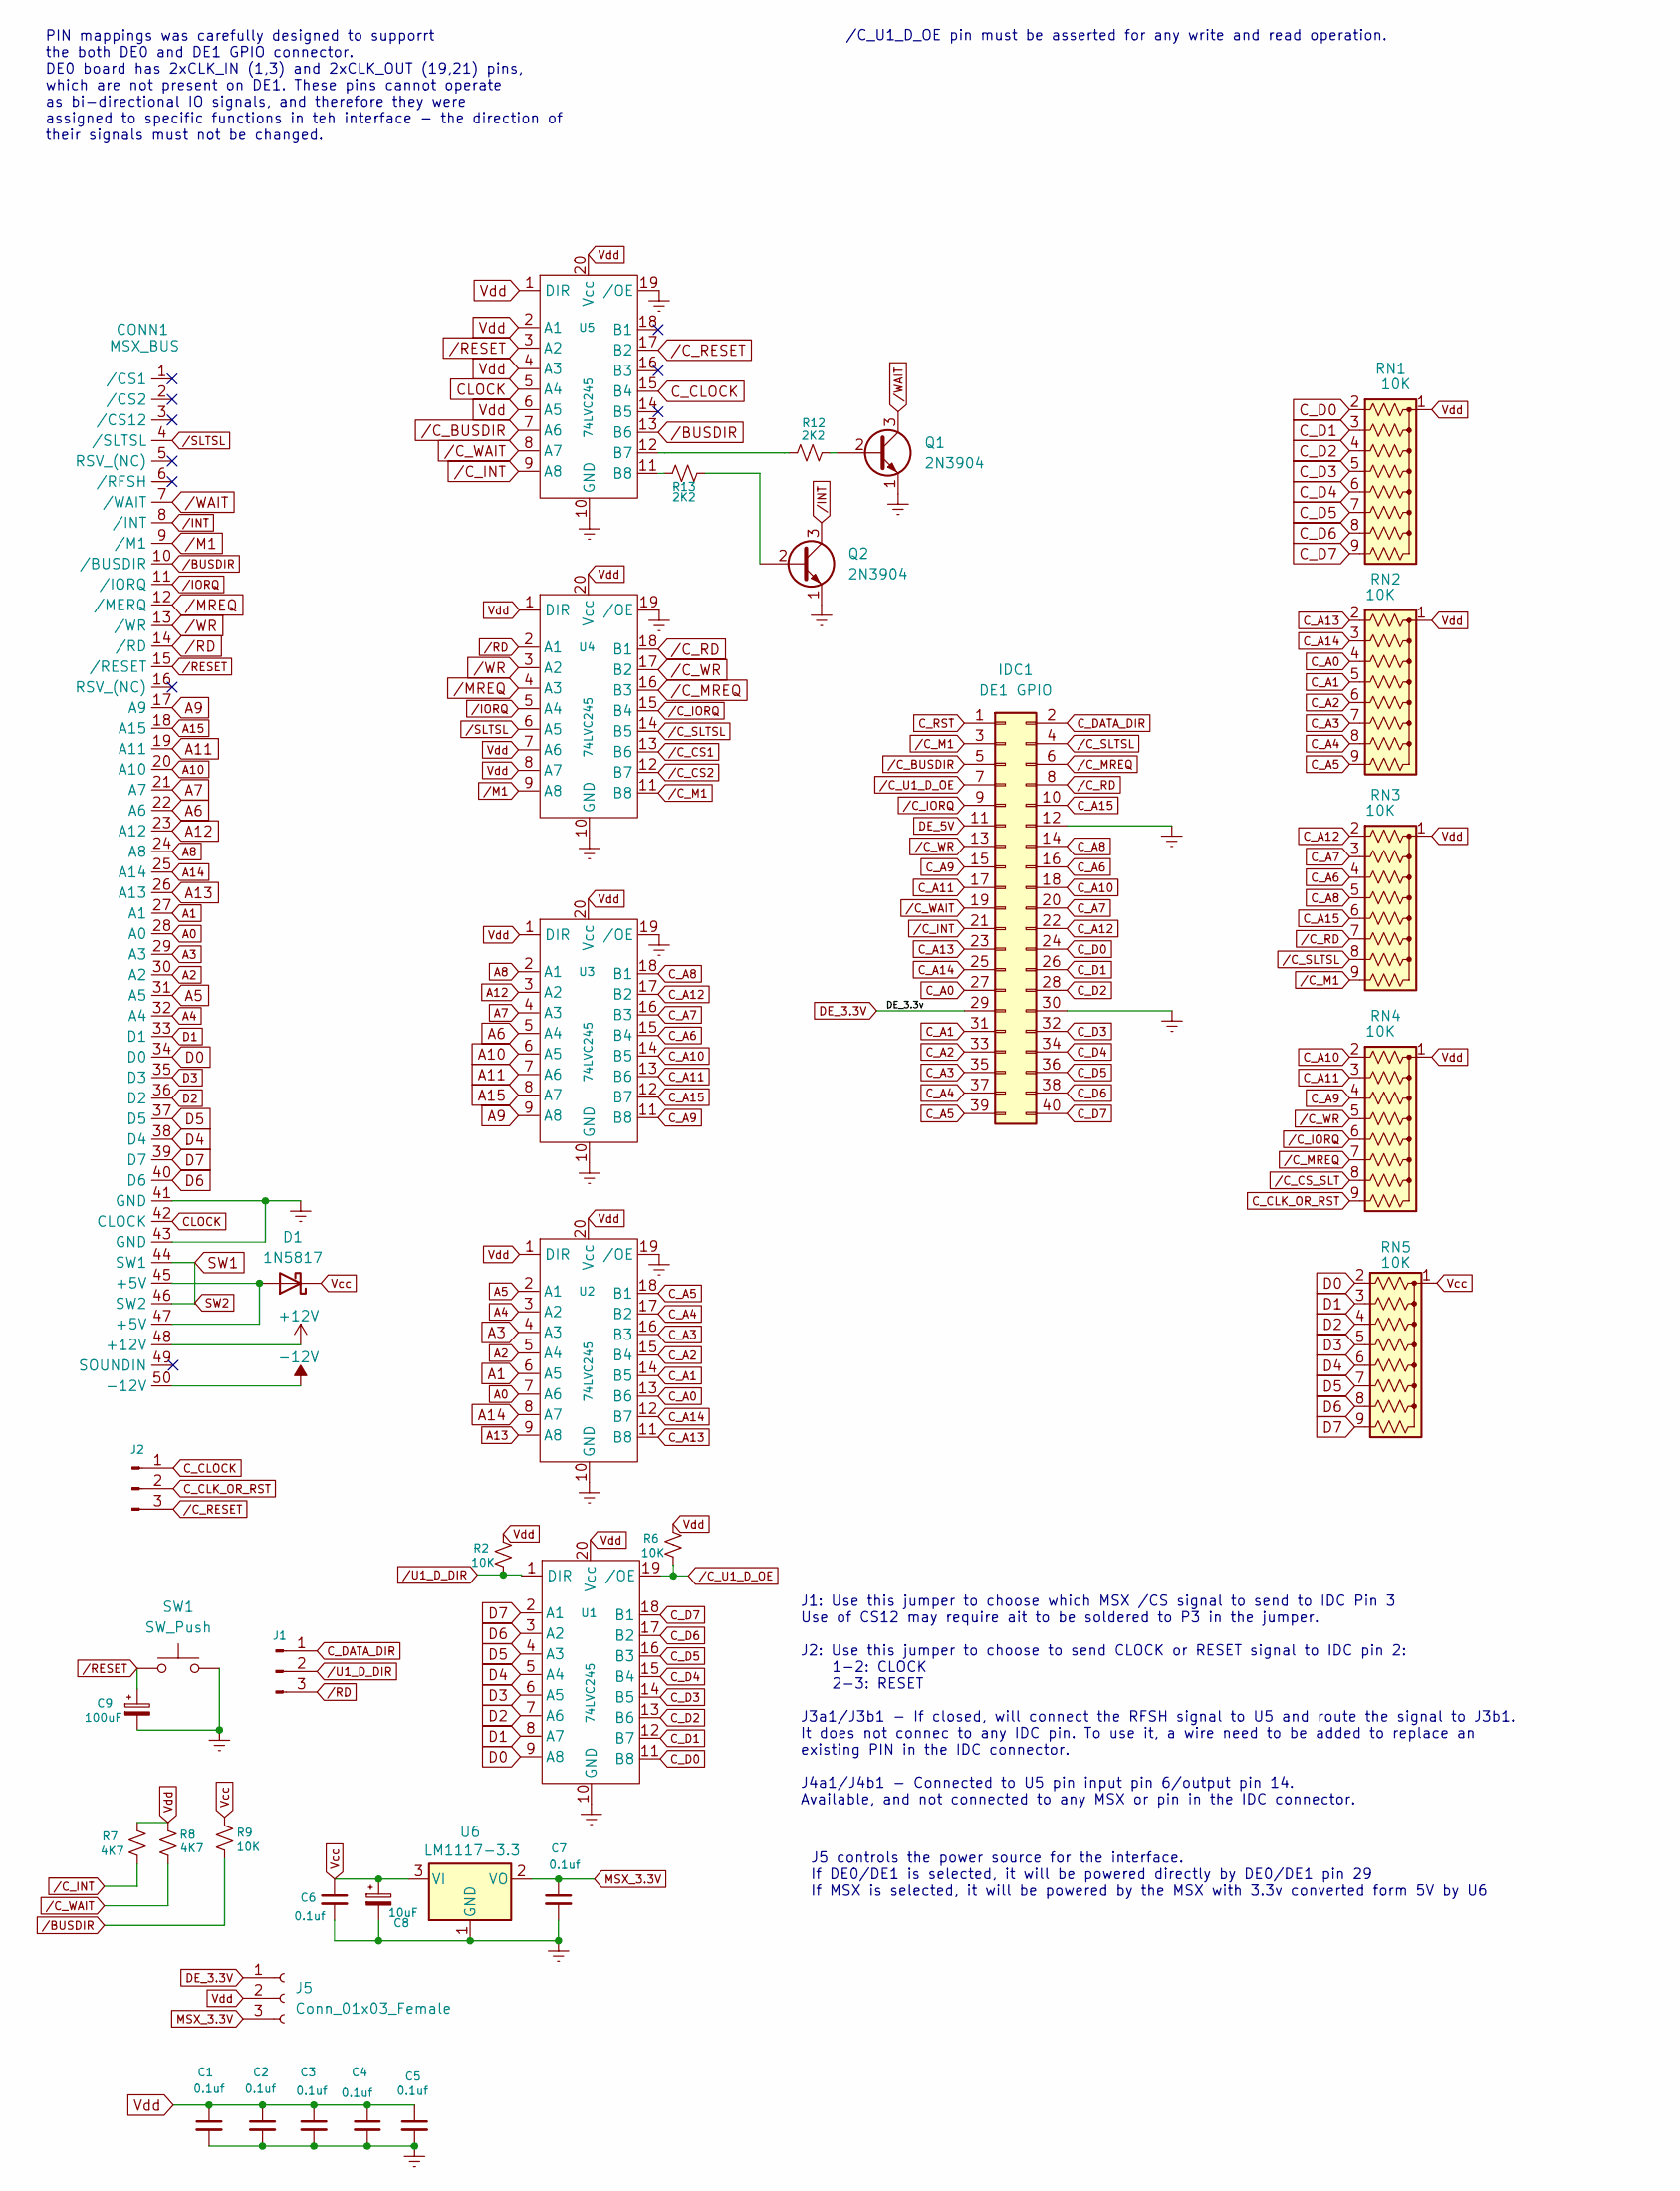
[picture p18: schematic MSX_FPGA_Hat.kicad_sch, MSX FPGA Hat]

Parts:
C1, C2, C3, C4, C5, C6, C7: 0.1uf; C_Disc_D3.0mm_W1.6mm_P2.50mm
C8: 10uF; CP_Radial_D6.3mm_P2.50mm
C9: 100uF; CP_Radial_D6.3mm_P2.50mm
CONN1: MSX_BUS; MSX_CART_SW_Official
D1: 1N5817; D_DO-41_SOD81_P10.16mm_Horizontal
IDC1: DE1 GPIO; PinHeader_2x20_P2.54mm_Vertical
J1: J1; PinHeader_1x03_P2.54mm_Vertical
J2: J2; PinHeader_1x03_P2.54mm_Vertical
J5: Conn_01x03_Female; PinHeader_1x03_P2.54mm_Vertical
Q1, Q2: 2N3904; TO-92_Inline
R2, R6, R9: 10K; R_Axial_DIN0207_L6.3mm_D2.5mm_P7.62mm_Horizontal
R7, R8: 4K7; R_Axial_DIN0207_L6.3mm_D2.5mm_P7.62mm_Horizontal
R12, R13: 2K2; R_Axial_DIN0207_L6.3mm_D2.5mm_P7.62mm_Horizontal
RN1, RN2, RN3, RN4, RN5: 10K; R_Array_SIP9
SW1: SW_Push; PinSocket_1x02_P2.54mm_Vertical
U1, U2, U3, U4, U5: 74LVC245; DIP-20_W7.62mm
U6: LM1117-3.3; SOT-223-3_TabPin2

Connections:
+12V: CONN1.48 (+12V)
-12V: CONN1.50 (-12V)
A0: CONN1.28 (A0), U2.7 (A6)
A1: CONN1.27 (A1), U2.6 (A5)
A2: CONN1.30 (A2), U2.5 (A4)
A3: CONN1.29 (A3), U2.4 (A3)
A4: CONN1.32 (A4), U2.3 (A2)
A5: CONN1.31 (A5), U2.2 (A1)
A6: CONN1.22 (A6), U3.5 (A4)
A7: CONN1.21 (A7), U3.4 (A3)
A8: CONN1.24 (A8), U3.2 (A1)
A9: CONN1.17 (A9), U3.9 (A8)
A10: CONN1.20 (A10), U3.6 (A5)
A11: CONN1.19 (A11), U3.7 (A6)
A12: CONN1.23 (A12), U3.3 (A2)
A13: CONN1.26 (A13), U2.9 (A8)
A14: CONN1.25 (A14), U2.8 (A7)
A15: CONN1.18 (A15), U3.8 (A7)
CLOCK: CONN1.42 (CLOCK), U5.5 (A4)
C_A0: IDC1.27, RN2.4 (R3), U2.13 (B6)
C_A1: IDC1.31, RN2.5 (R4), U2.14 (B5)
C_A2: IDC1.33, RN2.6 (R5), U2.15 (B4)
C_A3: IDC1.35, RN2.7 (R6), U2.16 (B3)
C_A4: IDC1.37, RN2.8 (R7), U2.17 (B2)
C_A5: IDC1.39, RN2.9 (R8), U2.18 (B1)
C_A6: IDC1.16, RN3.4 (R3), U3.15 (B4)
C_A7: IDC1.20, RN3.3 (R2), U3.16 (B3)
C_A8: IDC1.14, RN3.5 (R4), U3.18 (B1)
C_A9: IDC1.15, RN4.4 (R3), U3.11 (B8)
C_A10: IDC1.18, RN4.2 (R1), U3.14 (B5)
C_A11: IDC1.17, RN4.3 (R2), U3.13 (B6)
C_A12: IDC1.22, RN3.2 (R1), U3.17 (B2)
C_A13: IDC1.23, RN2.2 (R1), U2.11 (B8)
C_A14: IDC1.25, RN2.3 (R2), U2.12 (B7)
C_A15: IDC1.10, RN3.6 (R5), U3.12 (B7)
C_CLK_OR_RST: J2.2, RN4.9 (R8)
C_CLOCK: J2.1, U5.15 (B4)
C_D0: IDC1.24, RN1.2 (R1), U1.11 (B8)
C_D1: IDC1.26, RN1.3 (R2), U1.12 (B7)
C_D2: IDC1.28, RN1.4 (R3), U1.13 (B6)
C_D3: IDC1.32, RN1.5 (R4), U1.14 (B5)
C_D4: IDC1.34, RN1.6 (R5), U1.15 (B4)
C_D5: IDC1.36, RN1.7 (R6), U1.16 (B3)
C_D6: IDC1.38, RN1.8 (R7), U1.17 (B2)
C_D7: IDC1.40, RN1.9 (R8), U1.18 (B1)
C_DATA_DIR: IDC1.2, J1.1
C_RST: IDC1.1
D0: CONN1.34 (D0), RN5.2 (R1), U1.9 (A8)
D1: CONN1.33 (D1), RN5.3 (R2), U1.8 (A7)
D2: CONN1.36 (D2), RN5.4 (R3), U1.7 (A6)
D3: CONN1.35 (D3), RN5.5 (R4), U1.6 (A5)
D4: CONN1.38 (D4), RN5.6 (R5), U1.5 (A4)
D5: CONN1.37 (D5), RN5.7 (R6), U1.4 (A3)
D6: CONN1.40 (D6), RN5.8 (R7), U1.3 (A2)
D7: CONN1.39 (D7), RN5.9 (R8), U1.2 (A1)
DE_3.3V: IDC1.29, J5.1
DE_5V: IDC1.11
GNDREF: C1.2, C2.2, C3.2, C4.2, C5.2, C6.2, C7.2, C8.2, C9.2, CONN1.41 (GND), CONN1.43 (GND), IDC1.12, IDC1.30, Q1.1 (E), Q2.1 (E), SW1.2, U1.10 (GND), U2.10 (GND), U2.19 (/OE), U3.10 (GND), U3.19 (/OE), U4.10 (GND), U4.19 (/OE), U5.10 (GND), U5.19 (/OE), U6.1 (GND)
MSX_3.3V: C7.1, J5.3, U6.2 (VO)
unnamed: CONN1.45 (+5V), CONN1.47 (+5V), D1.2 (A)
unnamed: Q1.2 (B), R12.1
unnamed: Q2.2 (B), R13.1
unnamed: R12.2, U5.12 (B7)
unnamed: R13.2, U5.11 (B8)
SW1: CONN1.44 (SW1), CONN1.46 (SW2)
Vcc: C6.1, C8.1, D1.1 (K), R9.1, RN5.1 (common), U6.3 (VI)
Vdd: C1.1, C2.1, C3.1, C4.1, C5.1, J5.2, R2.1, R6.1, R7.1, R8.1, RN1.1 (common), RN2.1 (common), RN3.1 (common), RN4.1 (common), U1.20 (Vcc), U2.1 (DIR), U2.20 (Vcc), U3.1 (DIR), U3.20 (Vcc), U4.1 (DIR), U4.7 (A6), U4.8 (A7), U4.20 (Vcc), U5.1 (DIR), U5.2 (A1), U5.4 (A3), U5.6 (A5), U5.20 (Vcc)
/BUSDIR: CONN1.10 (/BUSDIR), R9.2, U5.13 (B6)
/C_BUSDIR: IDC1.5, U5.7 (A6)
/C_CS1: U4.13 (B6)
/C_CS2: U4.12 (B7)
/C_CS_SLT: RN4.8 (R7)
/C_INT: IDC1.21, R7.2, U5.9 (A8)
/C_IORQ: IDC1.9, RN4.6 (R5), U4.15 (B4)
/C_M1: IDC1.3, RN3.9 (R8), U4.11 (B8)
/C_MREQ: IDC1.6, RN4.7 (R6), U4.16 (B3)
/C_RD: IDC1.8, RN3.7 (R6), U4.18 (B1)
/C_RESET: J2.3, U5.17 (B2)
/C_SLTSL: IDC1.4, RN3.8 (R7), U4.14 (B5)
/C_U1_D_OE: IDC1.7, R6.2, U1.19 (/OE)
/C_WAIT: IDC1.19, R8.2, U5.8 (A7)
/C_WR: IDC1.13, RN4.5 (R4), U4.17 (B2)
/INT: CONN1.8 (/INT), Q2.3 (C)
/IORQ: CONN1.11 (/IORQ), U4.5 (A4)
/M1: CONN1.9 (/M1), U4.9 (A8)
/MREQ: CONN1.12 (/MERQ), U4.4 (A3)
/RD: CONN1.14 (/RD), J1.3, U4.2 (A1)
/RESET: C9.1, CONN1.15 (/RESET), SW1.1, U5.3 (A2)
/SLTSL: CONN1.4 (/SLTSL), U4.6 (A5)
/U1_D_DIR: J1.2, R2.2, U1.1 (DIR)
/WAIT: CONN1.7 (/WAIT), Q1.3 (C)
/WR: CONN1.13 (/WR), U4.3 (A2)

Notes on the sheet:
PIN mappings was carefully designed to supporrt the both DE0 and DE1 GPIO connector. DE0 board has 2xCLK_IN (1,3) and 2xCLK_OUT (19,21) pins, which are not present on DE1. These pins cannot operate as bi-directional IO signals, and therefore they were assigned to specific functions in teh interface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
/C_U1_D_OE pin must be asserted for any write and read operation.
J1: Use this jumper to choose which MSX /CS signal to send to IDC Pin 3 Use of CS12 may require ait to be soldered to P3 in the jumper. J2: Use this jumper to choose to send CLOCK or RESET signal to IDC pin 2: 1-2: CLOCK 2-3: RESET J3a1/J3b1 - If closed, will connect the RFSH signal to U5 and route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
J5 controls the power source for the interface. If DE0/DE1 is selected, it will be powered directly by DE0/DE1 pin 29 If MSX is selected, it will be powered by the MSX with 3.3v converted form 5V by U6

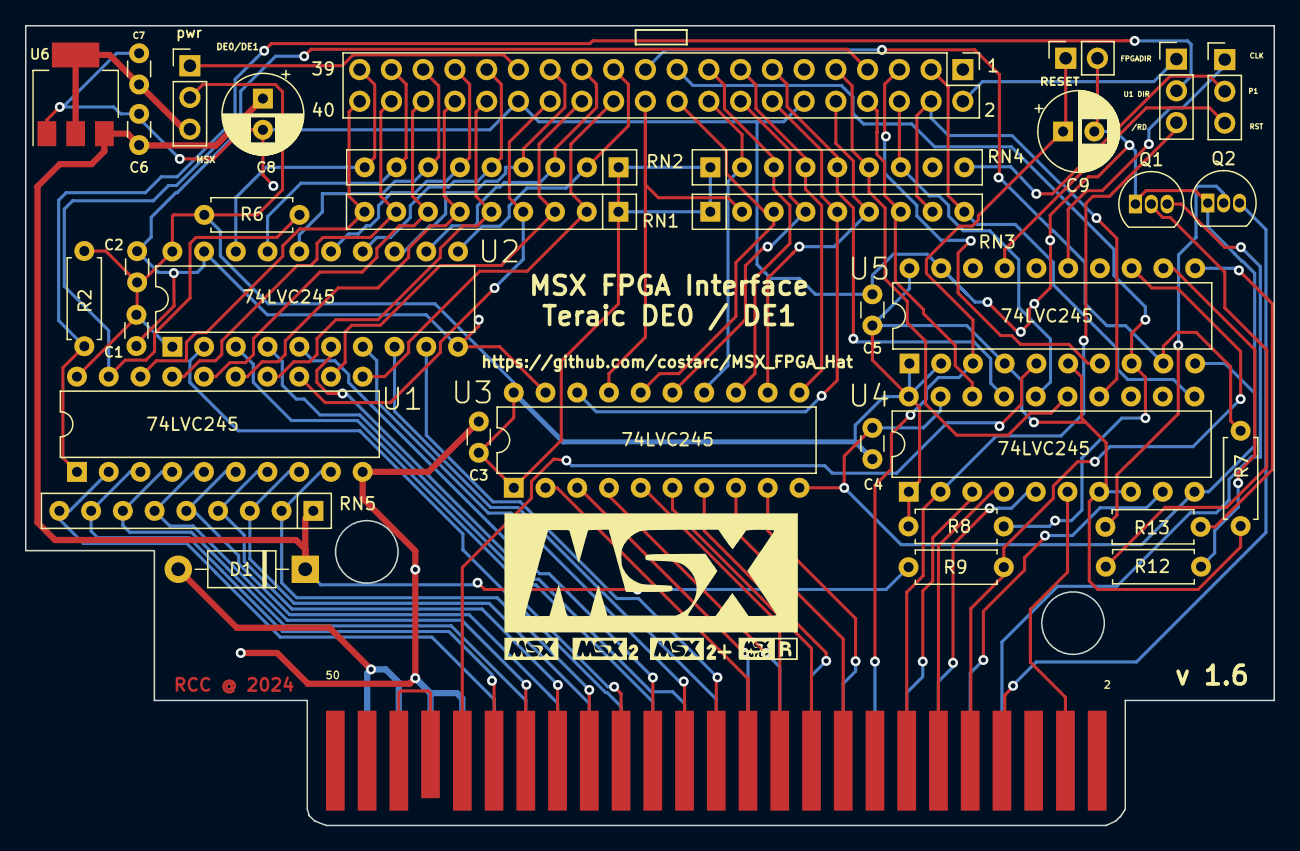
[picture p19: board Hardware Interface/Previous Versions/v1.6/MSX_FPGA_Hat.kicad_pcb from above]

Board: 2 copper layers, 99.9 x 64.0 mm, 36 parts (0 on the bottom side), 85 nets.
