costarc/MSX_FPGA_Hat/Hardware Interface/DE0_Addon_Board/DE0_Addon_Board.kicad_pcb

## KiCad design Hardware Interface/DE0_Addon_Board/DE0_Addon_Board.kicad_pcb (2023-02-21)

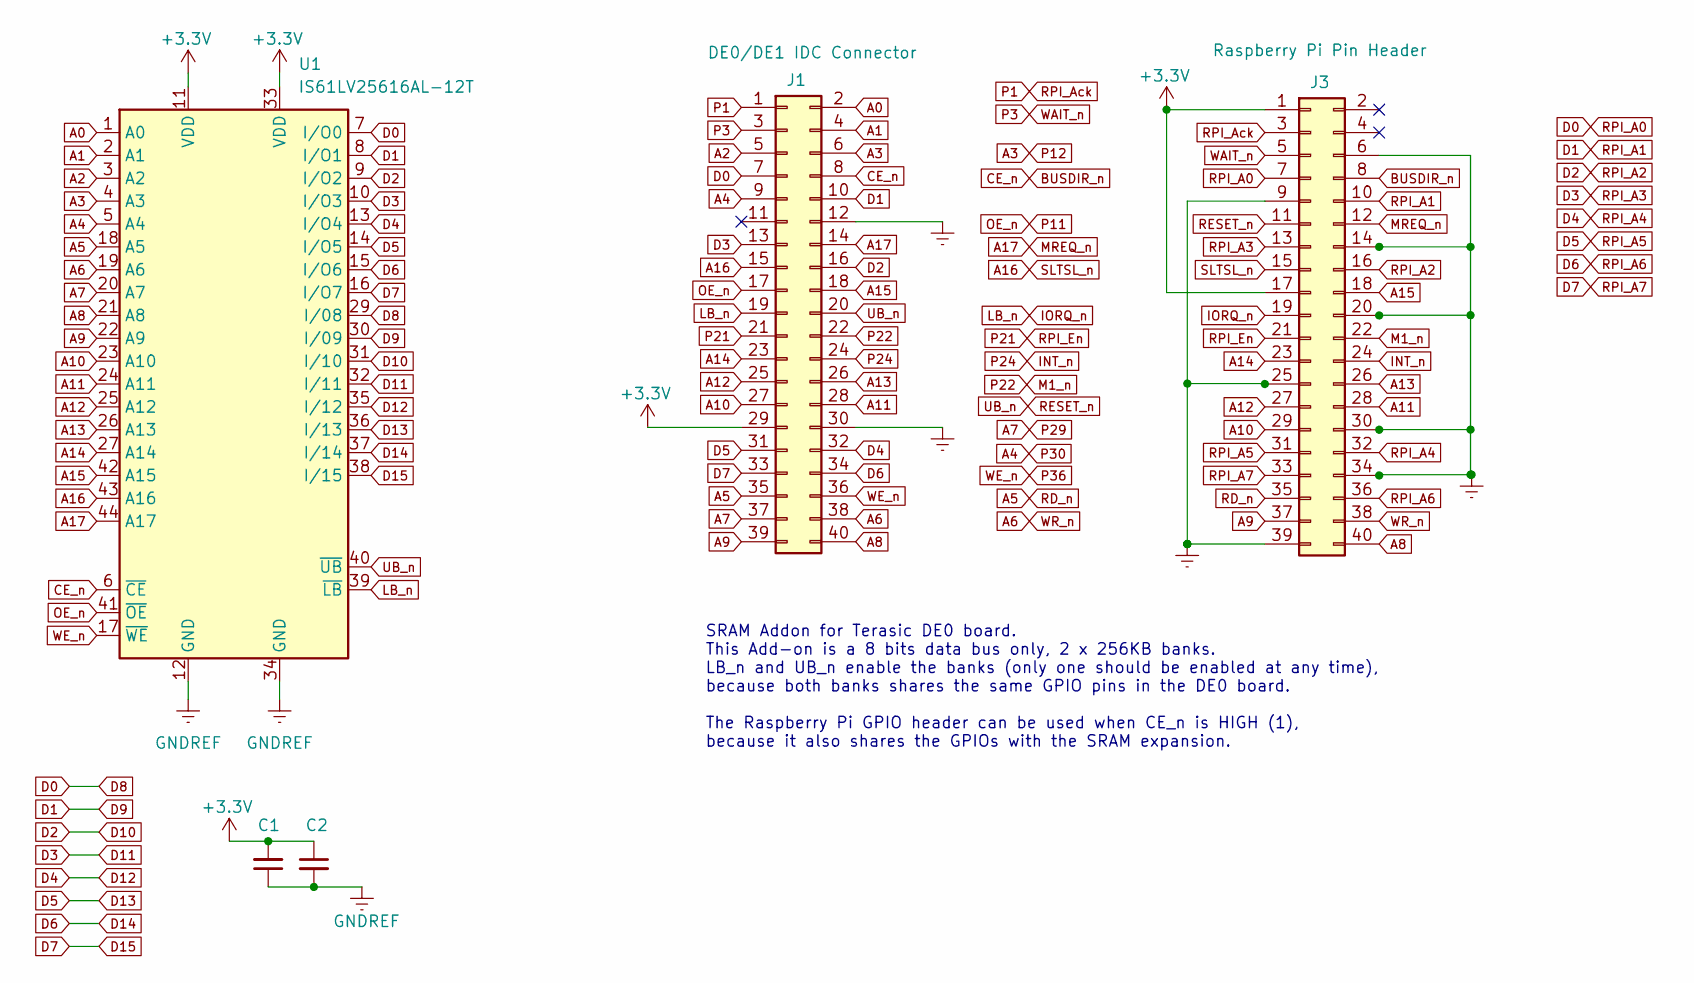
[picture p20: schematic DE0_Addon_Board.kicad_sch, Terasic DE0 SRAM & Raspberry Pi Addon Board]

Parts:
C1, C2: C_Small; C_0603_1608Metric_Pad1.08x0.95mm_HandSolder
J1: DE0/DE1 IDC Connector; PinSocket_2x20_P2.54mm_Vertical
J3: Raspberry Pi Pin Header; PinHeader_2x20_P2.54mm_Vertical
U1: IS61LV25616AL-12T; SOP80P1176X120-44N

Connections:
+3.3V: C1.2, C2.1, J1.29, J3.1, J3.17, U1.11 (VDD), U1.33 (VDD)
A0: J1.2, U1.1 (A0)
A1: J1.4, U1.2 (A1)
A2: J1.5, U1.3 (A2)
A3: J1.6, U1.4 (A3)
A4: J1.9, U1.5 (A4)
A5: J1.35, J3.35, U1.18 (A5)
A6: J1.38, J3.38, U1.19 (A6)
A7: J1.37, U1.20 (A7)
A8: J1.40, J3.40, U1.21 (A8)
A9: J1.39, J3.37, U1.22 (A9)
A10: J1.27, J3.29, U1.23 (A10)
A11: J1.28, J3.28, U1.24 (A11)
A12: J1.25, J3.27, U1.25 (A12)
A13: J1.26, J3.26, U1.26 (A13)
A14: J1.23, J3.23, U1.27 (A14)
A15: J1.18, J3.18, U1.42 (A15)
A16: J1.15, J3.15, U1.43 (A16)
A17: J1.14, J3.12, U1.44 (A17)
BUSDIR_n: J1.8, J3.8, U1.6 (~CE)
D0: J1.7, J3.7, U1.7 (I/O0), U1.29 (I/08)
D1: J1.10, J3.10, U1.8 (I/O1), U1.30 (I/09)
D10: J1.16, J3.16, U1.9 (I/O2), U1.31 (I/10)
D11: J1.13, J3.13, U1.10 (I/O3), U1.32 (I/11)
D12: J1.32, J3.32, U1.13 (I/O4), U1.35 (I/12)
D13: J1.31, J3.31, U1.14 (I/O5), U1.36 (I/13)
D14: J1.34, J3.36, U1.15 (I/O6), U1.37 (I/14)
D15: J1.33, J3.33, U1.16 (I/O7), U1.38 (I/15)
GNDREF: C1.1, C2.2, J1.12, J1.30, J3.6, J3.9, J3.14, J3.20, J3.25, J3.30, J3.34, J3.39, U1.12 (GND), U1.34 (GND)
INT_n: J1.24, J3.24
IORQ_n: J1.19, J3.19, U1.39 (~LB)
M1_n: J1.22, J3.22
OE_n: J1.17, U1.41 (~OE)
P1: J1.1, J3.3
P3: J1.3, J3.5
P21: J1.21, J3.21
P36: J1.36, U1.17 (~WE)
RESET_n: J1.20, J3.11, U1.40 (~UB)

Notes on the sheet:
SRAM Addon for Terasic DE0 board. This Add-on is a 8 bits data bus only, 2 x 256KB banks. LB_n and UB_n enable the banks (only one should be enabled at any time), because both banks shares the same GPIO pins in the DE0 board. The Raspberry Pi GPIO header can be used when CE_n is HIGH (1), because i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

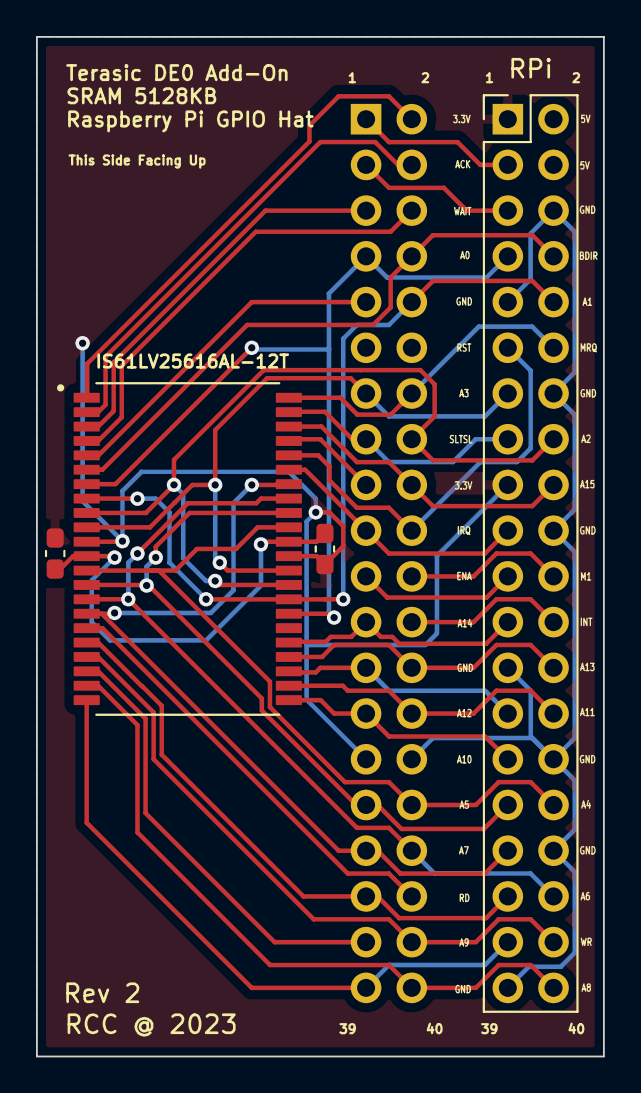
[picture p21: board DE0_Addon_Board.kicad_pcb from above]

Board: 2 copper layers, 31.5 x 56.6 mm, 5 parts (1 on the bottom side), 38 nets.
