costarc/MSX_FPGA_Hat/Reference Designs/Altera DE1  Project/WIP/SD_Nextor/db/MSXDOS2_Top.smp_dump.txt

State Machine - |MSXDOS2_Top|spi:portaspi|state_s
Name state_s.s_done state_s.s_running state_s.s_cleaning state_s.s_idle 
state_s.s_idle 0 0 0 0 
state_s.s_cleaning 0 0 1 1 
state_s.s_running 0 1 0 1 
state_s.s_done 1 0 0 1 
