costarc/MSX_FPGA_Hat/Reference Designs/Altera DE1  Project/WIP/ClockedDesigns/SDMapper/SDMapper_Top.vhd

-- MSX_DE0/DE1 FPGA Interface
-- Ronivon Costa @ 2023
--
-- MSXDOS2 (acutally it has Nextor Operating System in the Flash) is one of the many Reference Designs
-- I created for the MSX FPGA Interface.
-- MSX_FPGA_Interface is an interface the allows MSX computers to connect to the mentioned FPGA development boards,
-- safely (provides needed signal level shift between 3.3v and 5v).
-- This connecton makes it possible to user the development boards as generic peripherals.
-- --------------------------------------------------------------------------------------------------------------------------------------
-- Acknowledgment:
--
-- Most of this core was re-used from the amazing MSX SD Mapper V2, by Fabio Belavenuto - https://github.com/fbelavenuto/msxsdmapperv2
-- I had to make many changes to make it work in with the MSX FPGA Interface and the Terasic DE0/DE1 boards.
--  
-- Notable parts I changed includes:
--  -> ROM address decoding, where I prefer using a more natural "mathematical" language rather than "bit" language
--  -> SD Card signal assigments - I added some additional signals to the top-level and drive the SD card signals from there.
--  -> The 25MHZ clock for the SPI is created from the internal 50MHZ clock in the DE0/DE1
--  -> Many more, check the comments thorughout the code.
-- --------------------------------------------------------------------------------------------------------------------------------------
library ieee ;
use ieee.std_logic_1164.all;
use IEEE.std_logic_unsigned.all;

Entity SDMapper_TOP is
port (
    CLOCK_24:	  	in std_logic_vector(1 downto 0);		-- 24 MHz
    CLOCK_27:		in std_logic_vector(1 downto 0);		--	27 MHz
    CLOCK_50:		in std_logic;								--	50 MHz
    EXT_CLOCK:		in std_logic;								--	External Clock
                    
    KEY:				in std_logic_vector(3 downto 0);		--	Pushbutton[3:0]
                    
    SW:				in std_logic_vector(9 downto 0);		--	Toggle Switch[9:0]
                    
    HEX0:				out std_logic_vector(6 downto 0);	--	Seven Segment Digit 0
    HEX1:				out std_logic_vector(6 downto 0);	--	Seven Segment Digit 1
    HEX2:				out std_logic_vector(6 downto 0);	--	Seven Segment Digit 2
    HEX3:				out std_logic_vector(6 downto 0);	--	Seven Segment Digit 3
                    
    LEDG:				out std_logic_vector(7 downto 0);	--	LED Green[7:0]
    LEDR:				out std_logic_vector(9 downto 0);	--	LED Red[9:0]
                    
    UART_TXD:		out std_logic;								--	UART Transmitter
    UART_RXD:		in std_logic;								--	UART Receiver
                    
    DRAM_DQ:			inout std_logic_vector(15 downto 0);--	SDRAM Data bus 16 Bits
    DRAM_ADDR:		out std_logic_vector(11 downto 0);	--	SDRAM Address bus 12 Bits
    DRAM_LDQM:		out std_logic;								--	SDRAM Low-byte Data Mask 
    DRAM_UDQM:		out std_logic;								--	SDRAM High-byte Data Mask
    DRAM_WE_N:		out std_logic;								--	SDRAM Write Enable
    DRAM_CAS_N:		out std_logic;								--	SDRAM Column Address Strobe
    DRAM_RAS_N:		out std_logic;								--	SDRAM Row Address Strobe
    DRAM_CS_N:		out std_logic;								--	SDRAM Chip Select
    DRAM_BA_0:		out std_logic;								--	SDRAM Bank Address 0
    DRAM_BA_1:		out std_logic;								--	SDRAM Bank Address 0
    DRAM_CLK:		out std_logic;								--	SDRAM Clock
    DRAM_CKE:		out std_logic;								--	SDRAM Clock Enable
                    
    FL_DQ:			inout std_logic_vector(7 downto 0);	--	FLASH Data bus 8 Bits
    FL_ADDR:			out std_logic_vector(21 downto 0);	--	FLASH Address bus 22 Bits
    FL_WE_N:			out std_logic;								--	FLASH Write Enable
    FL_RST_N:		out std_logic;								--	FLASH Reset
    FL_OE_N:			out std_logic;								--	FLASH Output Enable
    FL_CE_N:			out std_logic;								--	FLASH Chip Enable
                    
    SRAM_DQ:			inout std_logic_vector(15 downto 0);--	SRAM Data bus 16 Bits
    SRAM_ADDR:		out std_logic_vector(17 downto 0);	--	SRAM Address bus 18 Bits
    SRAM_UB_N:		out std_logic;								--	SRAM High-byte Data Mask 
    SRAM_LB_N:		out std_logic;								--	SRAM Low-byte Data Mask 
    SRAM_WE_N:		out std_logic;								--	SRAM Write Enable
    SRAM_CE_N:		out std_logic;								--	SRAM Chip Enable
    SRAM_OE_N:		out std_logic;								--	SRAM Output Enable
    							
    I2C_SDAT:		inout std_logic;							--	I2C Data
    I2C_SCLK:		out std_logic;								--	I2C Clock
    							
    PS2_DAT:			in std_logic;							--	PS2 Data
    PS2_CLK:			in std_logic;							--	PS2 Clock
    							
    TDI:				in std_logic;  							-- CPLD -> FPGA (data in)
    TCK:				in std_logic;  							-- CPLD -> FPGA (clk)
    TCS:				in std_logic;  							-- CPLD -> FPGA (CS)
    TDO:				out std_logic; 							-- FPGA -> CPLD (data out)
    							
    VGA_HS:			out std_logic;								--	VGA H_SYNC
    VGA_VS:			out std_logic;								--	VGA V_SYNC
    VGA_R:   		out std_logic_vector(3 downto 0);	--	VGA Red[3:0]
    VGA_G:	 		out std_logic_vector(3 downto 0);	--	VGA Green[3:0]
    VGA_B:   		out std_logic_vector(3 downto 0);	--	VGA Blue[3:0]
                    
    AUD_ADCLRCK:	inout std_logic;							--	Audio CODEC ADC LR Clock
    AUD_ADCDAT:		in std_logic;								--	Audio CODEC ADC Data
    AUD_DACLRCK:	inout std_logic;							--	Audio CODEC DAC LR Clock
    AUD_DACDAT:		out std_logic;								--	Audio CODEC DAC Data
    AUD_BCLK:		inout std_logic;							--	Audio CODEC Bit-Stream Clock
    AUD_XCK:			out std_logic;								--	Audio CODEC Chip Clock

    SD1_CS:			out std_logic;							--	
    SD1_SCK:		out std_logic;							--	
    SD1_MOSI: 		out std_logic;							--	
    SD1_MISO: 		in std_logic;							--	
	 
    --GPIO_0:			inout std_logic_vector(35 downto 0);--	GPIO Connection 0
    SD2_CS:			out std_logic;							--	
    SD2_SCK:		out std_logic;							--	
    SD2_MOSI: 		out std_logic;							--	
    SD2_MISO: 		in std_logic;							--	
	 
    -- MSX Bus
    A:				in std_logic_vector(15 downto 0);
    D:				inout std_logic_vector(7 downto 0);
    RD_n:			in std_logic;
    WR_n:			in std_logic;
    MREQ_n:			in std_logic;
    IORQ_n:			in std_logic;
    SLTSL_n:		in std_logic;
    U1OE_n:			out std_logic;
    CS_n:			in std_logic;
    BUSDIR_n:		out std_logic;
    M1_n:			in std_logic;
    INT_n:			out std_logic;
    WAIT_n:			out std_logic;
	 RESET_n:		in std_logic); 
end SDMapper_TOP;

architecture bevioural of SDMapper_TOP is
	
	component decoder_7seg
	port (
		NUMBER		: in   std_logic_vector(3 downto 0);
		HEX_DISP	: out  std_logic_vector(6 downto 0));
	end component;

    component clock_25mhz
    PORT (
        inclk0              : IN STD_LOGIC  := '0';
        c0                  : OUT STD_LOGIC);
    end component;
	
	signal HEXDIGIT0		: std_logic_vector(3 downto 0);
	signal HEXDIGIT1		: std_logic_vector(3 downto 0);
	signal HEXDIGIT2		: std_logic_vector(3 downto 0);
	signal HEXDIGIT3		: std_logic_vector(3 downto 0);

	signal s_msx_clk_div	: std_logic_vector(31 downto 0) := "00000000000000000000000000000001";
	signal s_msx_clk_div2: std_logic_vector(7 downto 0) := "00000001";
	signal s_led_clk		: std_logic;
	signal s_msx_clk		: std_logic;
	signal s_reset			: std_logic := '0';
	signal s_wait_n: std_logic;
	signal s_sltsl_en		: std_logic;
	signal spi_data		: std_logic_vector(7 downto 0);
	signal spi_read		: std_logic;
	signal FL_READ_EN		: std_logic;
	
	-- Flash ASCII16
	signal rom_bank_wr_s	: std_logic;
	signal rom_bank1_q	: std_logic_vector(2 downto 0);
	signal rom_bank2_q	: std_logic_vector(3 downto 0);
	signal s_flashbase	: std_logic_vector(23 downto 0);
	signal s_rom_a			: std_logic_vector(31 downto 0);
	signal s_sltsl_rom_en	: std_logic;
	
	-- MSX-DOS & Nextor & SDCard
	signal clock_i			: std_logic := '0';
	signal clock_i_w		: std_logic;
	signal sd_wp_i			: std_logic_vector(1 downto 0);
	signal sd_pres_n_i	: std_logic_vector(1 downto 0);
	signal regs_cs_s		: std_logic;
	
	-- SPI port
	signal spi_cs_s		: std_logic;
	signal sd_chg_q		: std_logic_vector(1 downto 0);
	signal sd_chg_s		: std_logic_vector(1 downto 0);
	signal status_s		: std_logic_vector(7 downto 0);
	signal spi_ctrl_wr_s	: std_logic;
	signal spi_ctrl_rd_s	: std_logic;
	signal sd_sel_q		: std_logic_vector(1 downto 0);
	signal s_spi_wait_n		: std_logic;

	-- Timer
	signal tmr_cnt_q		: std_logic_vector(15 downto 0);	-- clock 25MHz: decrement each 40ns
	signal tmr_wr_s		: std_logic;
	signal tmr_rd_s		: std_logic;
	
	signal s_sd_cs			: std_logic;
	signal s_sd_clk		: std_logic;
	signal s_sd_mosi		: std_logic;
	signal s_sd_miso		: std_logic;

	-- Mapper
	signal s_io_addr 			: std_logic_vector(7 downto 0);
	signal s_fc					: std_logic_vector(4 downto 0) := "00011";
	signal s_fd					: std_logic_vector(4 downto 0) := "00010";
	signal s_fe					: std_logic_vector(4 downto 0) := "00001";
	signal s_ff					: std_logic_vector(4 downto 0) := "00000";
	signal s_mreq				: std_logic;
	signal s_iorq_r			: std_logic;
	signal s_iorq_w			: std_logic;
	signal s_iorq_r_reg		: std_logic;
	signal s_iorq_w_reg		: std_logic;
	signal s_mapper_reg_w	: std_logic;
	signal s_sltsl_ram_en	: std_logic;
	
	signal s_SRAM_ADDR		: std_logic_vector(20 downto 0);	
	signal s_ffff_slt			: std_logic;
	signal slt_exp_n			: std_logic_vector(3 downto 0);
	signal s_expn_q			: std_logic_vector(7 downto 0);
		
begin

	-- Reset circuit
	-- The process implements a "pull-up" to WAIT_n signal to avoid it floating
    -- during a reset, which causes teh computer to freeze
	s_msx_clk <= RESET_n;
	s_reset <= KEY(0);
	INT_n  <= '1';
	
	--WAIT_n <= '0' when s_spi_wait_n = '0'	else 'Z';
	--WAIT_n <= '0' when s_spi_wait_n = '0'	else s_wait_n;
	--WAIT_n <= '1';
	--WAIT_n <= 'Z';
	--WAIT_n <= s_wait_n;
	--WAIT_n <= NOT s_spi_wait_n;
	--WAIT_n <= s_spi_wait_n;
	
	process(s_reset)
	begin
	if s_reset = '1' then
		s_wait_n <= '1';
	else
		s_wait_n <= 'Z';
	end if;
	end process;
	
	-- Some cool ligths flashing while you play games with your Real MSX and DE1 as Disk Drives
	-- Also used for debugging.
	LEDG(7 downto 1) <= s_reset & slt_exp_n & s_ffff_slt & s_sltsl_ram_en;
	LEDR <= s_reset & spi_cs_s & s_spi_wait_n & regs_cs_s & sd_sel_q & not sd_wp_i & not sd_pres_n_i;
	HEXDIGIT0 <= s_fc(3 downto 0);
	HEXDIGIT1 <= s_fd(3 downto 0);
	HEXDIGIT2 <= '0'&rom_bank1_q(2 downto 0);
	HEXDIGIT3 <= rom_bank2_q(3 downto 0);
	
	-- Generic Outputs signals to DE1
	BUSDIR_n <= '0' when s_iorq_r_reg = '1' else
	            '0' when s_sltsl_rom_en = '1' and RD_n = '0' else
					'0' when s_sltsl_ram_en = '1' and RD_n = '0' else
					'1';
					
	s_sltsl_en <= (not SLTSL_n) when SW(9) = '1' else '0';		-- Will only enable Cart emulation if SW(9) is '1'
	s_sltsl_rom_en <= not slt_exp_n(0) when SW(9) = '1' else '0';
	s_sltsl_ram_en <= not slt_exp_n(1) when SW(8) = '1' else '0';
	
	-- Enable output in U1 (74LVC245)
	--U1OE_n <= not (s_sltsl_en or s_iorq_r_reg or s_iorq_w_reg or spi_cs_s);
	U1OE_n <= not (s_sltsl_en or s_iorq_r_reg or s_iorq_w_reg);
	--U1OE_n <=	not (s_sltsl_ram_en or s_sltsl_ram_en or s_iorq_r_reg or s_iorq_w_reg);

	-- Detect access to slots - to be used with the slot expansor
	s_ffff_slt    <= '1' when A = x"FFFF" else '0';
	
	-- Mapper
	s_iorq_r		<= '1' when RD_n = '0' and  IORQ_n = '0' and M1_n = '1' else '0';
	s_iorq_w		<= '1' when WR_n = '0' and  IORQ_n = '0' and M1_n = '1' else '0';	
	s_mreq		<= '1' when RD_n = '0' and  MREQ_n = '0' else '0';
	s_io_addr	<= A(7 downto 0);
	s_iorq_r_reg <= '1' when s_iorq_r = '1' and (s_io_addr = x"FC" or s_io_addr = x"FD" or s_io_addr = x"FE" or s_io_addr = x"FF") else '0';
	s_iorq_w_reg <= '1' when s_iorq_w = '1' and (s_io_addr = x"FC" or s_io_addr = x"FD" or s_io_addr = x"FE" or s_io_addr = x"FF") else '0';

	
	-- FlashRAM physical pins - Mapper will be in expaned subslot 1
	SRAM_CE_N <= not s_sltsl_ram_en;								
	SRAM_OE_N <= '0';	
	SRAM_WE_N <= WR_n;
	SRAM_ADDR <= s_SRAM_ADDR(17 downto 0);
	SRAM_UB_N <= not s_SRAM_ADDR(18);						
	SRAM_LB_N <= s_SRAM_ADDR(18);	
	SRAM_DQ(7 downto 0)  <= D when s_sltsl_ram_en = '1' and WR_n = '0' and s_SRAM_ADDR(18) = '0' else (others => 'Z');
	SRAM_DQ(15 downto 8) <= D when s_sltsl_ram_en = '1' and WR_n = '0' and s_SRAM_ADDR(18) = '1' else (others => 'Z');			 
	s_SRAM_ADDR <= (s_fc * x"4000") + A when A < x"4000" else
						(s_fd * x"4000") + A - x"4000" when A < x"8000" else
						(s_fe * x"4000") + A - x"8000" when A < x"c000" else
						(s_ff * x"4000") + A - x"C000";
						
	process(s_reset,s_iorq_w_reg)
	begin
		if s_reset = '1' then
			s_fc <= "00011";
			s_fd <= "00010";
			s_fe <= "00001";
			s_ff <= "00000";
		elsif falling_edge(s_iorq_w_reg) then
			case s_io_addr is
					when x"FC" => s_fc <= D(4 downto 0);
					when x"FD" => s_fd <= D(4 downto 0);
					when x"FE" => s_fe <= D(4 downto 0);
					when x"FF" => s_ff <= D(4 downto 0);
					when others => null;
			end case ;
		end if;
	end process;
	
	-- -- End of Mapper Implementation

	-- FlashRAm (ROM) constant control signals
	FL_RST_N <= '1';
	FL_OE_N <= RD_n;
	
	-- Bank write - Detect writes in addresses 6000h - 7800h
	-- This works well with Zemmix, but not with Cano V-25 MSX2
	--rom_bank_wr_s <= '1' when s_sltsl_en = '1' and WR_n = '0' and A(15 downto 13) = "011" and A(11) = '0' else  '0';
	rom_bank_wr_s <= '1' when s_sltsl_rom_en = '1' and WR_n = '0' and ((A >= x"6000" and A <= x"67FF") OR (A >= x"7000" and A <= x"77FF")) else  '0';

	-- The FLASHRAM is shared with other cores. This register allows to define
	-- a specific address in the flash where the roms for this cores is written.
	-- ROMs for this core starts at postion 0x0000 and each ROM has 256KB
	--s_flashbase <= x"180000";		-- FlashRAM Address for Nextor Operating System
	s_flashbase <= x"000000";		-- FlashRAM Address for Nextor Operating System
	
	-- Checks address being access. Mirrors memory as per information in https://www.msx.org/wiki/MegaROM_Mappers#ASCII16_.28ASCII.29
	s_rom_a(23 downto 0) <= s_flashbase + (rom_bank1_q(2 downto 0) & A(13 downto 0)) when s_sltsl_rom_en = '1' and (A(15 downto 14) = "01" or A(15 downto 14) = "11") else		-- Bank1
                           s_flashbase + (rom_bank2_q(3 downto 0) & A(13 downto 0)) when s_sltsl_rom_en = '1' and (A(15 downto 14) = "10" or A(15 downto 14) = "00") else		-- Bank2:
	                        (others => '-');
	FL_READ_EN <= -- Excludes SPI range and regs range
		'1'	when A(15 downto 14) = "01" and s_sltsl_rom_en = '1' and RD_n = '0' and spi_cs_s = '0' and regs_cs_s = '0'	else
		'1'	when A(15 downto 14) = "10" and s_sltsl_rom_en = '1' and rom_bank2_q(3) = '1'					else		-- Only if bank > 7
		'0';	
		
	FL_CE_N <= not FL_READ_EN;
	
	-- Writting to the FLASHRAM is not going to be enabled! The FLASH is shared with other cores in this project, and I don't want to mess with that.
   -- FL_WE_N	<=	'0'	when A(15 downto 14) = "10" and s_sltsl_en = '1' and WR_n = '0'	else 	'1';
   regs_cs_s <= '1' when s_sltsl_rom_en = '1' and A >= x"7FF0" else '0';
	
	FL_ADDR <= s_rom_a(21 downto 0); 

	-- Load the MSX BUS with data from the devices in the core.
	-- Note that data from/to SD Card is loaded inside the SPI component, not here.
	D <= --spi_data when spi_read = '1' else
	     status_s when spi_ctrl_rd_s = '1' else																			-- SD Card
        tmr_cnt_q(15 downto 8) when tmr_rd_s = '1' else 																-- SD Card
		  s_expn_q when s_sltsl_en = '1' and s_ffff_slt = '1' and RD_n = '0' else		-- Slot Select exapnsion
		  FL_DQ when FL_READ_EN = '1' else								-- FlasRAM / ROM 
		  SRAM_DQ(7 downto 0) when s_sltsl_ram_en = '1' and RD_n = '0' and s_SRAM_ADDR(18) = '0' else	-- SRAM / Mapper
	     SRAM_DQ(15 downto 8) when s_sltsl_ram_en = '1' and RD_n = '0' and s_SRAM_ADDR(18) = '1' else	-- SRAM / Mapper
		  "111" & s_fc when s_iorq_r = '1' and s_io_addr = x"FC" else												-- SRAM / Mapper	
		  "111" & s_fd when s_iorq_r = '1' and s_io_addr = x"FD" else												-- SRAM / Mapper
		  "111" & s_fe when s_iorq_r = '1' and s_io_addr = x"FE" else												-- SRAM / Mapper
		  "111" & s_ff when s_iorq_r = '1' and s_io_addr = x"FF" else												-- SRAM / Mapper
		  (others => 'Z'); 

	-- Status flags
	-- If no SD card is selected:
	-- b7-b2 : always 0
	-- b1-b0 : Switches status
	--
	-- If any SD card is selected:
	-- b7-b3 : always 0
	-- b2 : 1=Write protecton enabled for SD card slot selected
	-- b1 : 0=SD card present on slot selected
	-- b0 : 1=SD Card on slot selected changed since last read
	sd_pres_n_i <= not SW(1 downto 0);		-- SW1/SW0 is Flag of SDCard Inserted
	sd_wp_i <= not SW(3 downto 2);			-- SW3/SW2 is Write Protect for the SD Cards
	
	-- 
	-- SW(9) is the ROM/Nextor Enable switch
	-- SW(8) is the Mapper Enable switch
	-- SW(7) switch between Dev RoM and Main ROM
	status_s	<= "000000" & SW(7) & SW(9) when sd_sel_q = "00"	else															-- No SD selected
					"00000" & sd_wp_i(0) & sd_pres_n_i(0) & sd_chg_s(0) when sd_sel_q = "01" else		-- SD 1 selected
					"00000" & sd_wp_i(1) & sd_pres_n_i(1) & sd_chg_s(1) when sd_sel_q = "10" else		-- SD 2 selected
					(others => '-');
	
	spi_ctrl_wr_s <= '1' when s_sltsl_rom_en = '1' and WR_n = '0' and A = X"7FF0"	else '0';
	spi_ctrl_rd_s <= '1' when s_sltsl_rom_en = '1' and RD_n = '0' and A = X"7FF0"	else '0';
	
	-- 7B00 = 0111 1011
	-- 7F00 = 0111 1111

	spi_cs_s	<= '1'  when s_sltsl_rom_en = '1' and rom_bank1_q = "111" and	A >= x"7B00" and A < x"7F00" else '0';	
	tmr_wr_s <= '1' when s_sltsl_rom_en = '1' and WR_n = '0' and A = x"7FF1" else '0';
	tmr_rd_s <= '1' when s_sltsl_rom_en = '1' and RD_n = '0' and A = x"7FF1" else '0';

	-- Disk change FFs
	process (s_reset, spi_ctrl_rd_s, sd_sel_q, sd_pres_n_i(0))
	begin
		if s_reset = '1' then
			sd_chg_q(0) <= '0';
		elsif sd_pres_n_i(0) = '1' then
			sd_chg_q(0) <= '1';
		elsif falling_edge(spi_ctrl_rd_s) then
			if sd_sel_q = "01" then
				sd_chg_q(0) <= '0';
			end if;
		end if;
	end process;

	process (s_reset, spi_ctrl_rd_s, sd_sel_q, sd_pres_n_i(1))
	begin
		if s_reset = '1' then
			sd_chg_q(1) <= '0';
		elsif sd_pres_n_i(1) = '1' then
			sd_chg_q(1) <= '1';
		elsif falling_edge(spi_ctrl_rd_s) then
			if sd_sel_q = "10" then
				sd_chg_q(1) <= '0';
			end if;
		end if;
	end process;
	
	process (s_reset, spi_ctrl_rd_s)
	begin
		if s_reset = '1' then
			sd_chg_s <= (others => '0');
		elsif rising_edge(spi_ctrl_rd_s) then
			sd_chg_s <= sd_chg_q;
		end if;
	end process;

	-- Timer
	process (clock_i)
	begin
		if rising_edge(clock_i) then
			if tmr_wr_s = '1' then
				tmr_cnt_q(15 downto 8) <= D;
				tmr_cnt_q( 7 downto 0) <= (others => '1');
			elsif tmr_cnt_q /= 0 then
				tmr_cnt_q <= tmr_cnt_q - 1;
			end if;
		end if;
	end process;

	-- SPI Control register write
	process (s_reset, spi_ctrl_wr_s)
	begin
		if s_reset = '1' then
			sd_sel_q		<= "00";
		elsif falling_edge(spi_ctrl_wr_s) then
			sd_sel_q		<= D(1 downto 0);
		end if;
	end process;
	
	-- Bank write
	i_ROM_Banks:process (s_reset, rom_bank_wr_s)
	begin
		if s_reset = '1' then
			rom_bank1_q		<= (others => '0');
			rom_bank2_q		<= (others => '0');
		elsif falling_edge(rom_bank_wr_s) then
			case A(12) is
				when '0'   =>
					rom_bank1_q		<= D(2 downto 0);
				when '1'   =>
					rom_bank2_q		<= D(3 downto 0);
				when others =>
					null;
			end case;
		end if;
	end process;

	-- Generate the 25MHz clock_i for the SPI component
   -- 25MHz clock_i for the SPI component
    clock_25mhz_inst : clock_25mhz PORT MAP (
        inclk0   => CLOCK_50,
        c0       => clock_i
    );

	half_clock:process(clock_i)
	begin
		if s_reset = '1' then
			clock_i_w <= '0';
		elsif falling_edge(clock_i) then
			clock_i_w <= not clock_i_w;
		end if;
	end process;

	-- SPI Interface to the SD Cards
	portaspi: entity work.spi
	port map (
		clock_i			=> s_msx_clk,
		reset_n_i		=> not s_reset,
		-- CPU interface
		cs_i				=> spi_cs_s,
		data_bus_io		=> D,
		wr_n_i			=> WR_n,
		rd_n_i			=> RD_n,
		wait_n_o			=> WAIT_n, --s_spi_wait_n,
		-- SD card interface
		spi_sclk_o		=> s_sd_clk,
		spi_mosi_o		=> s_sd_mosi, --SD_CMD,
		spi_miso_i		=> s_sd_miso,  --SD_DAT 
		-- extra signals added for MSX_FPGA_Interface
		spi_dout			=>	spi_data,
		spi_rd_en		=> spi_read
	);
 	
	-- Signals to drive the SD Cards
	-- Device Drive 1 is the SD Card in the DE1
	SD1_CS	<= '0' when sd_sel_q(0) = '1' else '1';	
	SD1_SCK	<= s_sd_clk;
	SD1_MOSI	<= s_sd_mosi;
	s_sd_miso <= SD1_MISO when sd_sel_q(0) = '1' else SD2_MISO when sd_sel_q(1) = '1';
	
	-- Device Drive 2 is aN Optional 2nd SD Card connected to GPIO_0:
	-- GPIO_0[1] = SD2_CS
	-- GPIO_0[3] = SD2_SCK
	-- GPIO_0[5] = SD2_MOSI
	-- GPIO_0[7] = SD2_MISO
	SD2_CS	<= '0' when sd_sel_q(1) = '1' else '1';
	SD2_SCK	<= s_sd_clk;
	SD2_MOSI	<= s_sd_mosi;

	-- Interface for the 7 Segment Display
	-- Provides some cool flashing lights for you.
	DISPHEX0 : decoder_7seg PORT MAP (
			NUMBER		=>	HEXDIGIT0,
			HEX_DISP		=>	HEX0
		);		
	
	DISPHEX1 : decoder_7seg PORT MAP (
			NUMBER		=>	HEXDIGIT1,
			HEX_DISP		=>	HEX1
	);		
	
	DISPHEX2 : decoder_7seg PORT MAP (
			NUMBER		=>	HEXDIGIT2,
			HEX_DISP		=>	HEX2
	);		
	
	DISPHEX3 : decoder_7seg PORT MAP (
			NUMBER		=>	HEXDIGIT3,
			HEX_DISP		=>	HEX3
	);

	-- Expansor de slot
	exp: entity work.exp_slot
	port map (
		reset_n		=> not s_reset,
		sltsl_n		=> not s_sltsl_en,
		cpu_rd_n		=> RD_n,
		cpu_wr_n		=> WR_n,
		ffff			=> s_ffff_slt,
		cpu_a			=> A(15 downto 14),
		cpu_d			=> D,
		cpu_q			=> s_expn_q,
		exp_n			=> slt_exp_n
	);

	process(s_msx_clk_div2)
	variable ledg_reg : std_logic := '0';
	begin
		if rising_edge(s_msx_clk_div2) then
			s_msx_clk_div(31 downto 1) <= s_msx_clk_div(30 downto 0);
			if s_msx_clk_div(31) = '1' then
				s_msx_clk_div <= "00000000000000000000000000000001";
				s_msx_clk_div2(7 downto 1) <= s_msx_clk_div2(6 downto 0);
				if s_msx_clk_div2(7) = '1' then 
					s_msx_clk_div2 <= "00000001";
					ledg_reg := not ledg_reg;
				end if;
			end if;
		end if;
		
		LEDG(0) <= ledg_reg;
		
	end process;
	
	I2C_SDAT		<= 'Z';
   AUD_ADCLRCK	<= 'Z';
   AUD_DACLRCK	<= 'Z';
   AUD_BCLK		<= 'Z';
   DRAM_DQ		<= (others => 'Z');
   SRAM_DQ		<= (others => 'Z');
	
end bevioural;
