costarc/MSX_FPGA_Hat/Reference Designs/Altera DE0 Project/Clocked_Designs/Multi_Cartridge/Tools/rom.vhdl

library IEEE;
use IEEE.std_logic_1164.all;
use ieee.numeric_std.all;

entity rom is
	port(
		cs		: in std_logic;
		A		: in std_logic_vector(15 downto 0);
		D		: out std_logic_vector(7 downto 0)
	);
end rom;

architecture rtl of rom is
type ROM is array (0 to 32767) of std_logic_vector(7 downto 0);
constant galaga : rom := (
    x"41",
    x"42",
    x"17",
    x"40",
    x"00",
    x"00",
    x"00",
    x"00",
    x"00",
    x"00",
    x"00",
    x"00",
    x"00",
    x"00",
    x"00",
    x"00",
    x"07",
    x"47",
    x"41",
    x"4c",
    x"41",
    x"47",
    x"41",
    x"21",
    x"00",
    x"e0",
    x"11",
    x"01",
    x"e0",
    x"01",
    x"fe",
    x"0f",
    x"36",
    x"00",
    x"ed",
    x"b0",
    x"31",
    x"00",
    x"e7",
    x"cd",
    x"38",
    x"01",
    x"e6",
    x"cf",
    x"4f",
    x"e6",
    x"0c",
    x"87",
    x"87",
    x"b1",
    x"cd",
    x"3b",
    x"01",
    x"cd",
    x"ad",
    x"59",
    x"3e",
    x"c3",
    x"21",
    x"4c",
    x"40",
    x"32",
    x"9a",
    x"fd",
    x"22",
    x"9b",
    x"fd",
    x"fb",
    x"01",
    x"01",
    x"e2",
    x"cd",
    x"47",
    x"00",
    x"18",
    x"fe",
    x"31",
    x"00",
    x"e7",
    x"cd",
    x"3e",
    x"01",
    x"01",
    x"01",
    x"c2",
    x"cd",
    x"47",
    x"00",
    x"2a",
    x"09",
    x"e0",
    x"23",
    x"22",
    x"09",
    x"e0",
    x"cb",
    x"45",
    x"28",
    x"18",
    x"21",
    x"80",
    x"e7",
    x"f9",
    x"3e",
    x"20",
    x"5e",
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
    x"51",
    x"94",
    x"52",
    x"83",
    x"51",
    x"ac",
    x"52",
    x"ce",
    x"51",
    x"fd",
    x"51",
    x"77",
    x"52",
    x"93",
    x"52",
    x"6e",
    x"51",
    x"eb",
    x"7e",
    x"47",
    x"23",
    x"7e",
    x"23",
    x"e6",
    x"03",
    x"28",
    x"5c",
    x"0f",
    x"0f",
    x"0f",
    x"80",
    x"11",
    x"80",
    x"9f",
    x"83",
    x"5f",
    x"30",
    x"01",
    x"14",
    x"1a",
    x"86",
    x"c6",
    x"08",
    x"47",
    x"fa",
    x"5a",
    x"4f",
    x"fe",
    x"10",
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
