costarc/MSX_FPGA_Hat/Reference Designs/Altera DE0 Project/Clocked_Designs/Multi_Cartridge/Tools/rom_to_vhd.py

#!/cygdrive/c/Users/alpha/AppData/Local/Microsoft/WindowsApps/python3

import sys

fname = sys.argv[1]

#component=fname.split('.')[0]
component='rom'
size = len(open(fname,"rb").read())-1

print("library IEEE;")
print("use IEEE.std_logic_1164.all;")
print("use ieee.numeric_std.all;")
print("")
print("entity %s is" % component)
print("	port(")
print("		cs		: in std_logic;")
print("		A		: in std_logic_vector(15 downto 0);")
print("		D		: out std_logic_vector(7 downto 0)")
print("	);")
print("end %s;" % component)
print("")
print("architecture rtl of %s is" % component)
print("type MEMORY is array ( 0 to",size,") of std_logic_vector(7 downto 0);")
print("constant rom : MEMORY := (")
addr = 0
f = open(fname,"rb")
byte = True
while byte:
    byte = f.read(1).hex()
    if (byte):
        if addr < size:
            print("    x\"%s\"," % (byte))
        else:
            print("    x\"%s\"" % (byte))
        addr += 1
f.close()
print(");")
print("begin")
print("")
print("process (cs)")
print("begin")
print("if rising_edge(cs) then")
print("    D <= rom(to_integer(unsigned(A)));")
print("end if;")
print("end process;")
print("end;")
print("")
