costarc/MSX_FPGA_Hat/(commit log)

2022-11-13 Changed the schematic to use a NAND port via transitors - to remove the 74LS00. Started routing the PCB
    [MSX_IDC_Interface.kicad_pcb, MSX_IDC_Interface.kicad_sch]
2022-11-13 Added both NAD options to same schematic -with 74LS00 and other option with tranistors
    [MSX_IDC_Interface.kicad_pcb, MSX_IDC_Interface.kicad_sch]
2022-11-13 Safe guard commit - progressing with routing
    [MSX_IDC_Interface.kicad_pcb, MSX_IDC_Interface.kicad_sch]
2022-11-14 Finished routing. Rules chekc not done yet
    [MSX_IDC_Interface.kicad_pcb]
2022-11-14 Resolvig clearance issues - wip
    [MSX_IDC_Interface.kicad_pcb, MSX_IDC_Interface.kicad_sch]
2022-11-15 Changed NAND gate for XNOR gate (bug); Completed routing
    [MSX_IDC_Interface.kicad_pcb, MSX_IDC_Interface.kicad_sch]
2022-11-15 Resistors changed to 2.2k and routing completed
    [MSX_IDC_Interface.kicad_pcb]
2022-11-15 Added silkscreen to pcb
    [MSX_IDC_Interface.kicad_pcb]
2022-11-15 Version 1.0 with fabrication files
    [MSX_IDC_Interface.kicad_pcb, MSX_IDC_Interface.kicad_sch]
2022-11-16 Repositioned background silk and removed unwanted G** in the galaga silk. Continue being Verison 1.0
    [MSX_IDC_Interface.kicad_pcb]
2022-11-16 Generated updated Gerbers for verison 1.0
2022-12-13 Fixed missing 3v input
    [MSX_IDC_Interface.kicad_pcb, MSX_IDC_Interface.kicad_sch]
2022-12-13 Fixed missing 3v input & minor cosmetic change
    [MSX_IDC_Interface.kicad_sch]
2022-12-14 Changed directory structure; Added Altera DE1 qsf file (oin assignments to match MSX Bus
    [MSX_IDC_Interface.kicad_pcb, MSX_IDC_Interface.kicad_sch]
2022-12-14 Renamed the project from MSX IDC Interface to MSX DE1 hat
    [MSX_DE1_Hat.kicad_pcb, MSX_DE1_Hat.kicad_sch]
2022-12-14 Small change to silk text
    [MSX_DE1_Hat.kicad_pcb]
2022-12-14 Rev 1.1. Added pull ups for /OE; Changed Pull Ups to 10K; Changed silk screen
    [MSX_DE1_Hat-B_Cu.gbr, MSX_DE1_Hat-B_Mask.gbr, MSX_DE1_Hat-B_Paste.gbr, MSX_DE1_Hat-B_Silkscreen.gbr, MSX_DE1_Hat-Edge_Cuts.gbr, MSX_DE1_Hat-F_Cu.gbr, MSX_DE1_Hat-F_Mask.gbr, MSX_DE1_Hat-F_Paste.gbr]
2022-12-14 Changed LVC245 DIR signal - to be enabled via MSX /RD
    [MSX_DE1_Hat-B_Cu.gbr, MSX_DE1_Hat-B_Mask.gbr, MSX_DE1_Hat-B_Paste.gbr, MSX_DE1_Hat-B_Silkscreen.gbr, MSX_DE1_Hat-Edge_Cuts.gbr, MSX_DE1_Hat-F_Cu.gbr, MSX_DE1_Hat-F_Mask.gbr, MSX_DE1_Hat-F_Paste.gbr]
2022-12-15 Added Gerbers for V1.1
    [MSX_DE1_Hat-B_Cu.gbr, MSX_DE1_Hat-B_Mask.gbr, MSX_DE1_Hat-B_Paste.gbr, MSX_DE1_Hat-B_Silkscreen.gbr, MSX_DE1_Hat-Edge_Cuts.gbr, MSX_DE1_Hat-F_Cu.gbr, MSX_DE1_Hat-F_Mask.gbr, MSX_DE1_Hat-F_Paste.gbr]
2022-12-16 Updated PCB Rev 1.1 with IDC connector in right position
    [MSX_DE1_Hat.kicad_pcb, MSX_DE1_Hat.kicad_sch]
2023-01-06 Abandoned the idea of making this design support both DE1 & RPi
    [MSX_DE1_Hat.kicad_sch]
2023-01-07 Added working firmware / vhdl. Updated schematic and pcb to rmove not needed components
    [MSX_DE1_Hat.kicad_pcb, MSX_DE1_Hat.kicad_sch]
2023-01-08 Updated firmware and schematic following tests in Rev1.0 branch
    [MSX_DE1_Hat.kicad_sch]
2023-01-08 Starting routing of reivsed pcb
    [MSX_DE1_Hat.kicad_pcb, MSX_DE1_Hat.kicad_sch]
2023-01-09 Routing new pcb for v1.1
    [MSX_DE1_Hat.kicad_pcb, MSX_DE1_Hat.kicad_sch]
2023-01-09 Fabricatin files added for the PCB v1.1
    [MSX_DE1_Hat.kicad_pcb, MSX_DE1_Hat.kicad_sch]
2023-01-17 Added Gerber files
    [MSX_DE1_Hat.kicad_pcb, MSX_DE1_Hat.kicad_sch]
2023-01-17 Compatibel with DE0 & DE1
    [MSX_DE1_Hat.kicad_pcb, MSX_DE1_Hat.kicad_sch]
2023-01-17 Renamed kicad files to MSX FPGA Hat
    [MSX_FPGA_Hat.kicad_pcb, MSX_FPGA_Hat.kicad_sch]
2023-01-17 Fixed a type, cleaned up. Working multicart emulation
    [MSX_DE1_Top.vhd]
2023-01-21 Re-strcutured FPGA directories
    [MSX_FPGA_Hat.kicad_pcb, MSX_FPGA_Hat.kicad_sch]
2023-01-22 Mapper implementaation: registers implemented, MSX recognize more memory but bank switch is not working
    [MSX_DE1_Top.vhd, MegaROM_Top.vhd, SRAM512x8.vhd]
2023-01-22 Developing the MSXDOS2/Nextor reference design
    [MSXDOS2_Top.smp_dump.txt]
2023-01-23 DOS boots, but cannot find SD Cards
    [MSXDOS2_Top.smp_dump.txt]
2023-01-23 RAM can be used, but mapper is not working
    [SRAM512x8.vhd]
2023-01-24 Updated schmeatic and PCB to Rev 1.2
    [MSX_FPGA_Hat.kicad_pcb, MSX_FPGA_Hat.kicad_sch]
2023-01-24 Added gerbers in ZIP format
2023-01-25 Adding SDCard reference design
    [MSX_DE1_SDCard.smp_dump.txt]
2023-01-26 Tweaked with the enable signals and made more clean and simple
    [MSX_DE1_SDCard.smp_dump.txt]
2023-01-27 MSXDOS boots into DiSK BASIC, ROM Mapper working. SDCARD / SPIO not working
    [MSXDOS2_Top.smp_dump.txt]
2023-01-29 Added project for Add-On board SRAM 512KB for DE0
    [DE0_Addon_Board-B_Cu.gbr, DE0_Addon_Board-B_Mask.gbr, DE0_Addon_Board-B_Paste.gbr, DE0_Addon_Board-B_Silkscreen.gbr, DE0_Addon_Board-Edge_Cuts.gbr, DE0_Addon_Board-F_Cu.gbr, DE0_Addon_Board-F_Mask.gbr, DE0_Addon_Board-F_Paste.gbr]
2023-01-29 Added 2nd IDC connector in paralell with the SRAM
    [DE0_Addon_Board-B_Cu.gbr, DE0_Addon_Board-B_Mask.gbr, DE0_Addon_Board-B_Paste.gbr, DE0_Addon_Board-B_Silkscreen.gbr, DE0_Addon_Board-Edge_Cuts.gbr, DE0_Addon_Board-F_Cu.gbr, DE0_Addon_Board-F_Mask.gbr, DE0_Addon_Board-F_Paste.gbr]
2023-01-31 Success! Booting Nextor from SD CARD 1 and/or 2
    [MSXDOS2_Top.smp_dump.txt]
2023-01-31 Reverted the interface schema to v1.1, as it's verified that U1 does not need to be driven by its own 7 separate pin. BUSDIR in the FPGA will continue driving both MSX BUSDIR and U1 DIR pin
    [DE0_Addon_Board.kicad_pcb, DE0_Addon_Board.kicad_sch, MSX_FPGA_Hat.kicad_pcb, MSX_FPGA_Hat.kicad_sch]
2023-01-31 Reverted the interface schema to v1.1, as it's verified that U1 does not need to be driven by its own 7 separate pin. BUSDIR in the FPGA will continue driving both MSX BUSDIR and U1 DIR pin. Added re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
2023-01-31 Moving to version 1.2 as it's clear that the OD pin in the U1 is not being driven correctly and need a separate pin for this purpose. V1.2 has this change implemented
    [DE0_Addon_Board.kicad_pcb, DE0_Addon_Board.kicad_sch, MSX_FPGA_Hat.kicad_pcb, MSX_FPGA_Hat.kicad_sch]
2023-01-31 all versions available to facilitate debugging and working with the old revisons wired up for fixes
    [MSX_IDC_Interface.kicad_pcb, MSX_IDC_Interface.kicad_sch]
2023-01-31 Added proper readme
    [MSX_FPGA_Hat.kicad_sch]
2023-02-01 Added pin U1OE_n to controll /OE in U1; Update design files with this change
    [MSX_IDC_Interface - rewired.kicad_sch]
2023-02-02 Changing daughter board to support raspberry pin connector
    [DE0_Addon_Board.kicad_pcb]
2023-02-02 Addon-board changed to support Raspberry Pi in the GPIO connector
    [DE0_Addon_Board.kicad_pcb, DE0_Addon_Board.kicad_sch]
2023-02-04 tweaked busdir/U1 /oe. booting everythign on Zemmix
    [MSXDOS2_Top.smp_dump.txt]
2023-02-04 Mapper passed TESTRAM tests; With slot expansor implemented
2023-02-06 MegaRAM working without expanded slots.
2023-02-06 SDMapper added. Unstable on Canon V-8, although works well with Zemmix
    [MSXDOS2_Top.smp_dump.txt, SDMapper.smp_dump.txt]
2023-02-16 Changed footprint of SRAM decoupling capacitors to SMD 0603; Updated SRAM Addon for Rev.2
    [DE0_Addon_Board.kicad_pcb, DE0_Addon_Board.kicad_sch, SDMapper_Top.smp_dump.txt]
2023-02-17 Updated footprint for the pcb to make insertion into slot easier
    [MSX_FPGA_Hat.kicad_pcb]
2023-02-18 Galaga booting on DE0 using BlockROM
    [MSX_FPGA_Hat.kicad_sch]
2023-02-19 Working with the mapper for DE0 & DE1; it stopped workig with the new PCB v1.1
2023-02-20 MegaRM core functional with DE0 SRAM Addon
    [MSXDOS2_Top.smp_dump.txt, SDMapper.smp_dump.txt, SDMapper_Top.smp_dump.txt]
2023-02-21 Updated Add-On with silk in addresses for RPI
    [DE0_Addon_Board.kicad_pcb, DE0_Addon_Board.kicad_sch, MSX_FPGA_Hat.kicad_pcb, MSX_FPGA_Hat.kicad_sch]
2023-02-21 Updated schema and pcb with some cool silk and instructions
    [MSX_FPGA_Hat.kicad_pcb, MSX_FPGA_Hat.kicad_sch]
2023-02-21 Added option to power the interface by MSX
2023-02-21 Added pull-ups for int,wait,busdir (optional)
    [MSX_FPGA_Hat.kicad_pcb, MSX_FPGA_Hat.kicad_sch]
2023-02-21 small fix to the silk
    [MSX_FPGA_Hat.kicad_pcb]
2023-02-28 Updated edge connector to meet MSX specifications
    [MSX_FPGA_Hat.kicad_pcb, MSX_FPGA_Hat.kicad_sch]
2023-03-01 Finalized v1.3; new silk; new routing for soundin & rfsh; changed jumper J1
    [MSX_FPGA_Hat.kicad_pcb, MSX_FPGA_Hat.kicad_sch]
2023-03-14 SDCard access working using GPIO1 SDCARD 16GB. Does not recognize card in DE1 slot
2023-03-14 Fixed bug in pin assignment that was breaking SDCard functionality in DE1
    [SDMapper_Top.vhd]
2023-03-17 Updated footprint for cart with little move in hole places to better fit patola/brazil case
    [MSX_FPGA_Hat.kicad_pcb]
2023-05-14 Added pull-up with 4 x resistor arrays; added reset button
    [MSX_FPGA_Hat.kicad_pcb, MSX_FPGA_Hat.kicad_sch]
2023-05-14 Created dirctory v1.3 prior to merging new version 1.4
    [MSX_FPGA_Hat.kicad_pcb, MSX_FPGA_Hat.kicad_sch]
2023-05-15 Added Gerber for v1.4
2023-11-09 V 1.5
    [MSX_FPGA_Hat-B_Cu.gbr, MSX_FPGA_Hat-B_Mask.gbr, MSX_FPGA_Hat-B_Paste.gbr, MSX_FPGA_Hat-B_Silkscreen.gbr, MSX_FPGA_Hat-Edge_Cuts.gbr, MSX_FPGA_Hat-F_Cu.gbr, MSX_FPGA_Hat-F_Mask.gbr, MSX_FPGA_Hat-F_Paste.gbr]
2023-12-08 Changed SPI clock to PLL
2023-12-11 v1.6 candidate & v1.4 added for backup
    [MSX_FPGA_Hat.kicad_pcb, MSX_FPGA_Hat.kicad_sch]
2023-12-18 Version 2.0
    [MSX_FPGA_Hat.kicad_pcb, MSX_FPGA_Hat.kicad_sch]
2023-12-18 Removed temporary work folder
    [MSX_FPGA_Hat.kicad_pcb, MSX_FPGA_Hat.kicad_sch]
2023-12-18 Moved al previous versions to a separete folder
    [MSX_FPGA_Hat.kicad_pcb, MSX_FPGA_Hat.kicad_sch, MSX_IDC_Interface - rewired.kicad_sch, MSX_IDC_Interface.kicad_pcb, MSX_IDC_Interface.kicad_sch]
2024-02-03 ev 2.0
    [MSX_FPGA_Hat.kicad_pcb]
2024-02-03 v2.0 has a bug - added a info in the schematic
    [MSX_FPGA_Hat.kicad_sch]
2024-02-06 Master is currentl under development and tests for v2.0
    [MSX_FPGA_Hat.kicad_pcb, MSX_FPGA_Hat.kicad_sch]
